pengels22/home_controller/hardware/schematics/GREM Module.pdf

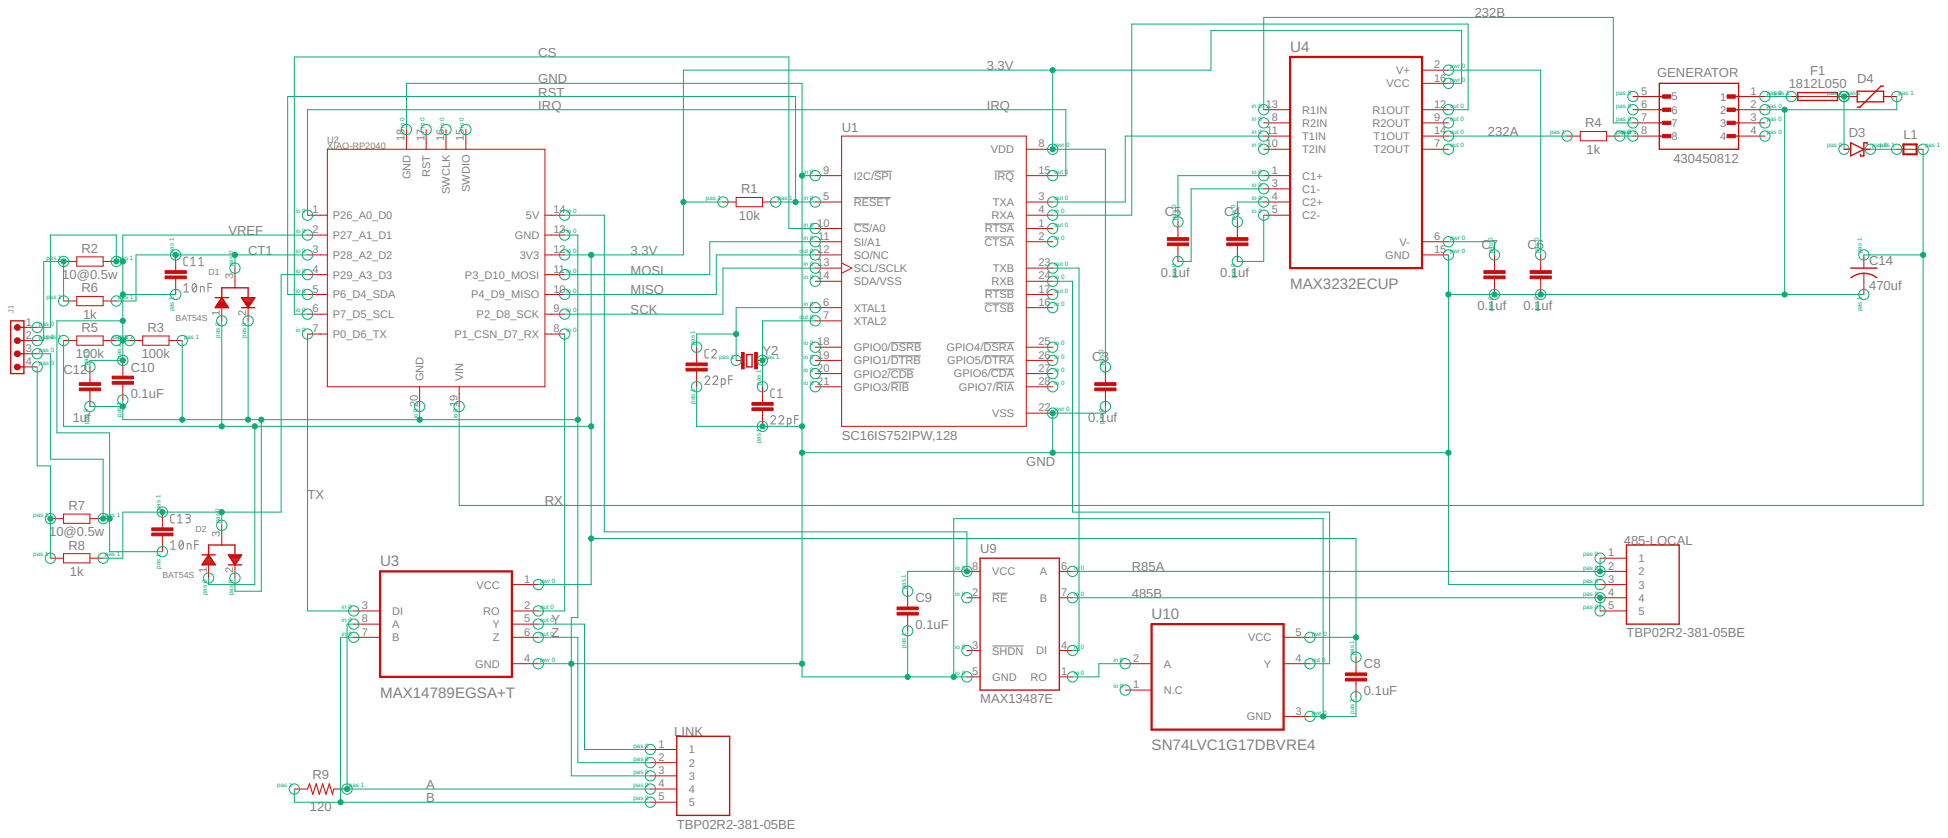
[picture p1: page 1]

U3 | RX | SC16IS752IPW,128

GND
