pengels22/home_controller/hardware/schematics/485 Module.pdf

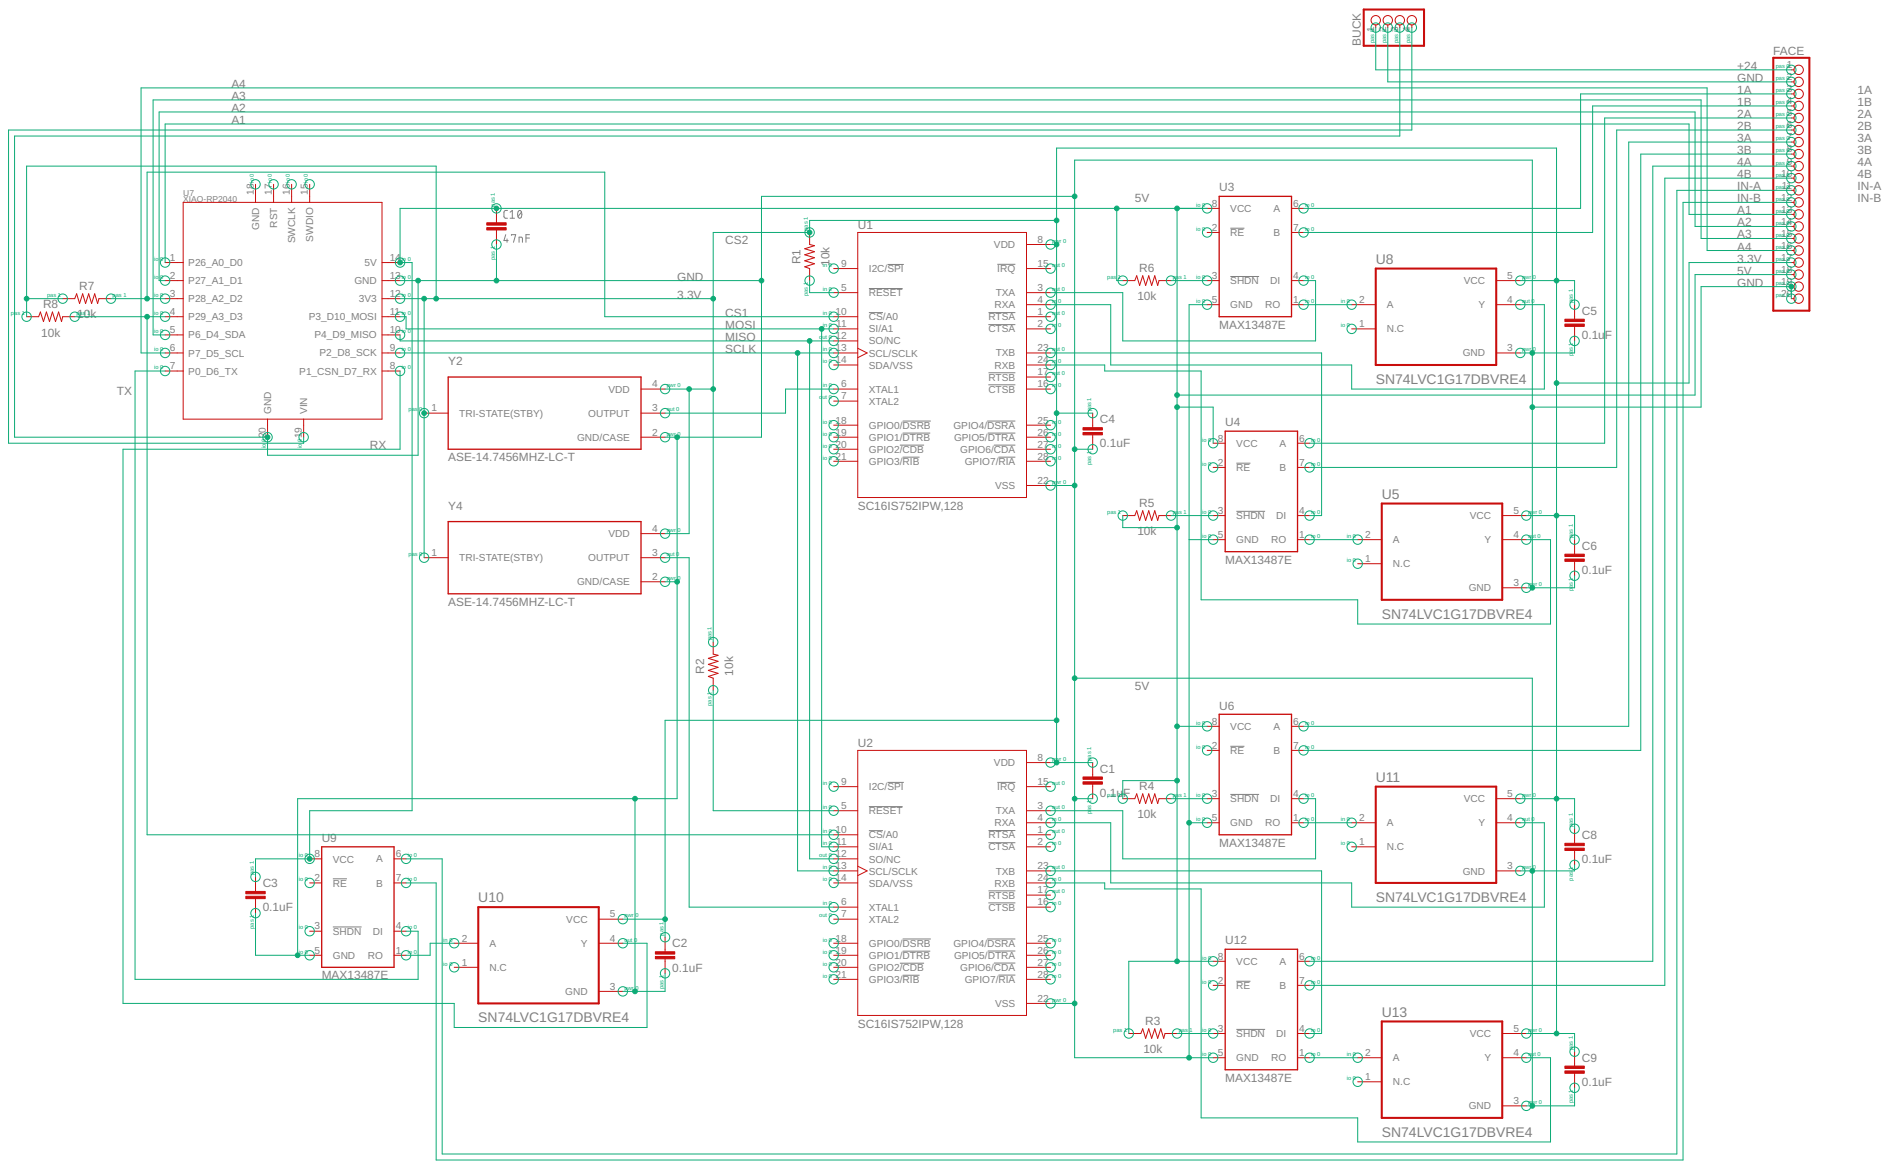
[picture p2: page 1]
