pengels22/home_controller/hardware/schematics/AIO Module.pdf

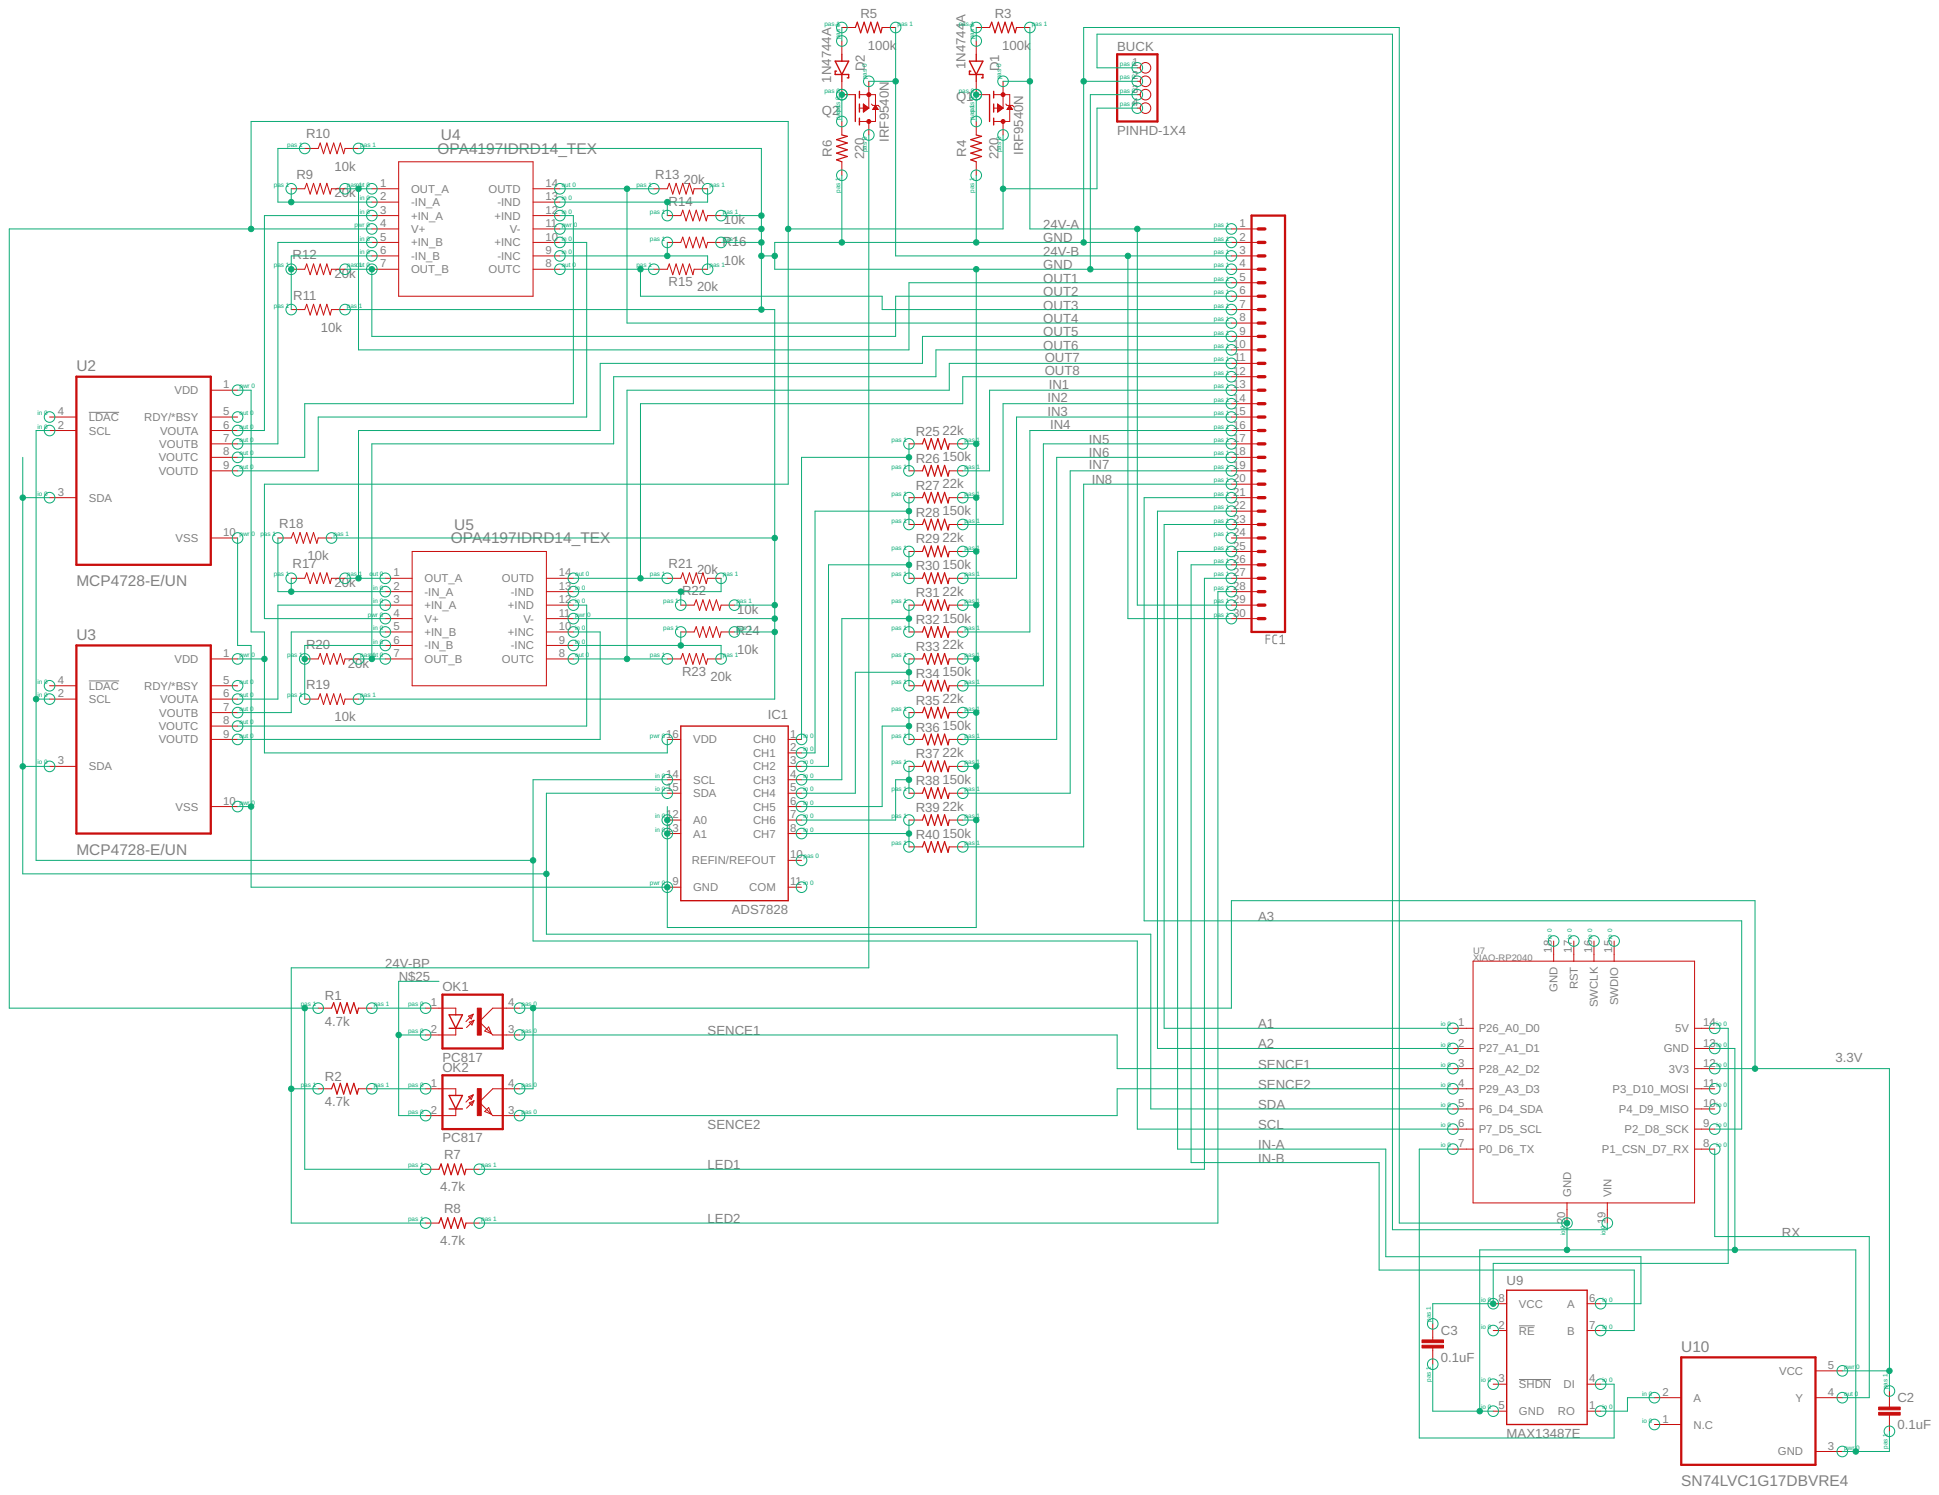
[picture p3: page 1]
