pengels22/home_controller/hardware/schematics/DI Module.pdf

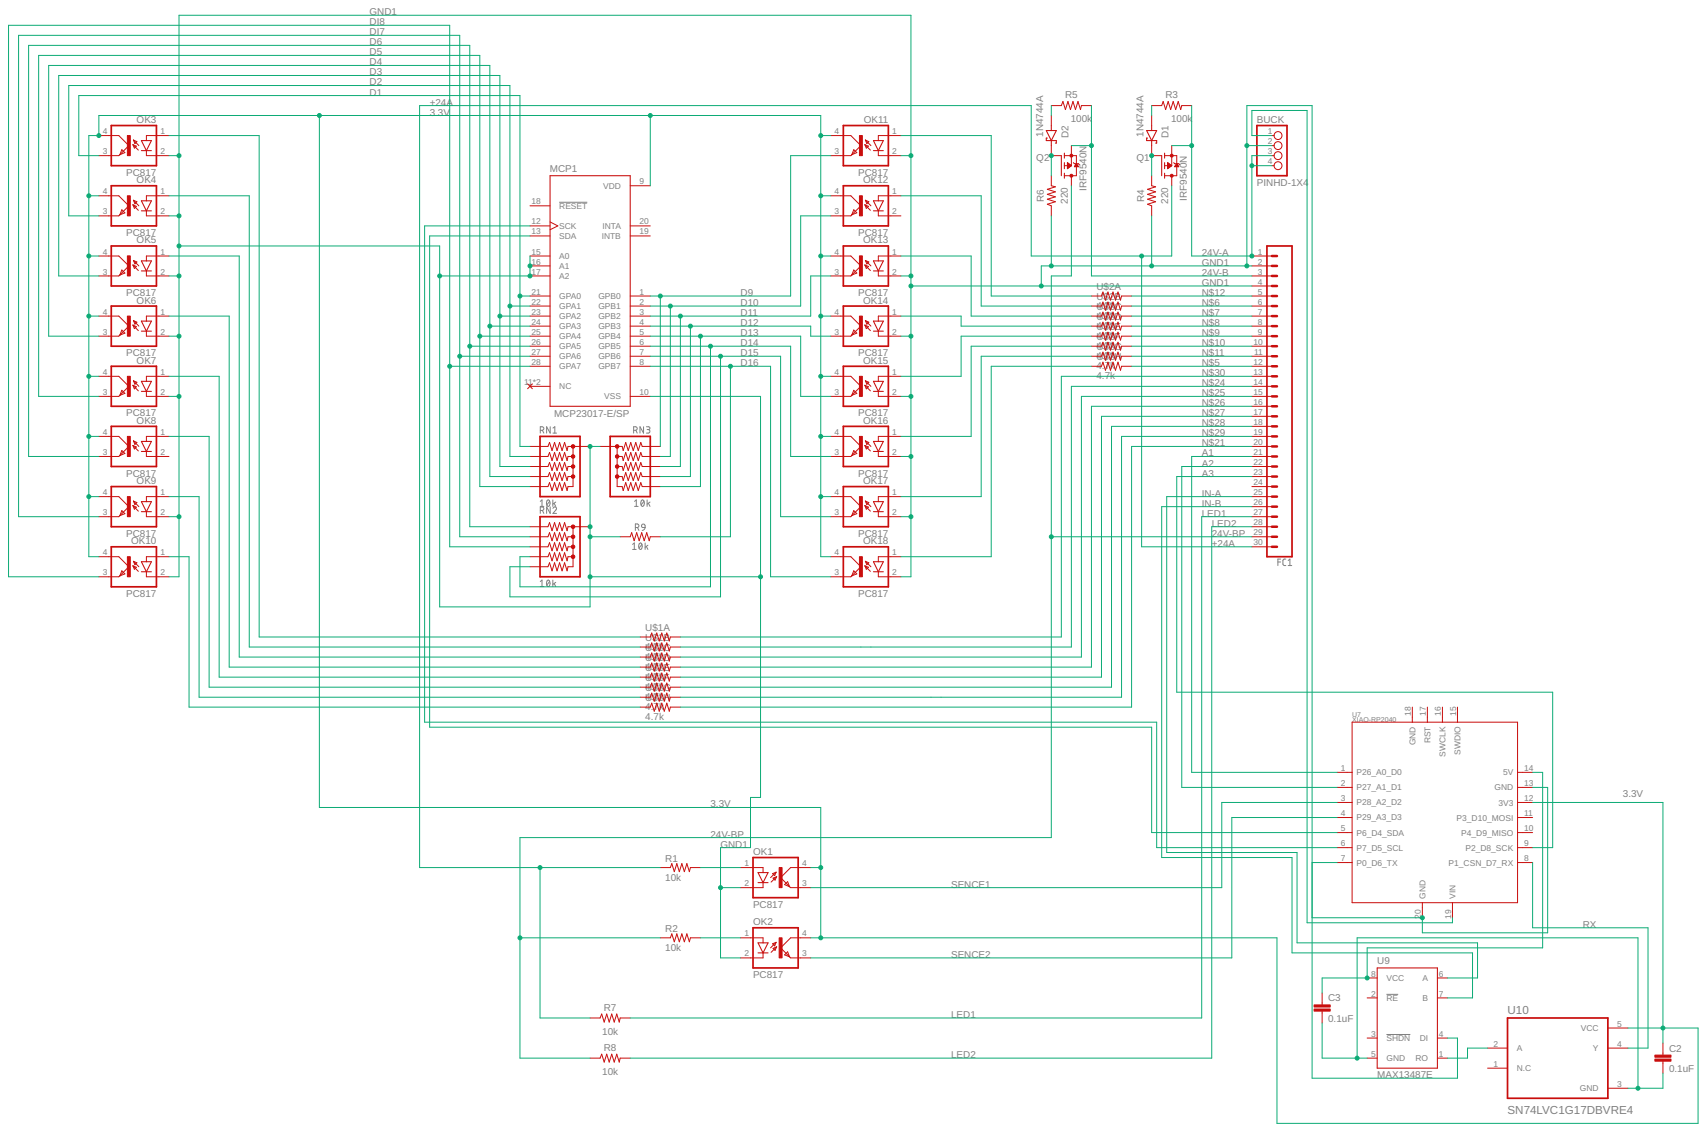
[picture p4: page 1]
