pengels22/home_controller/hardware/schematics/DO Module.pdf

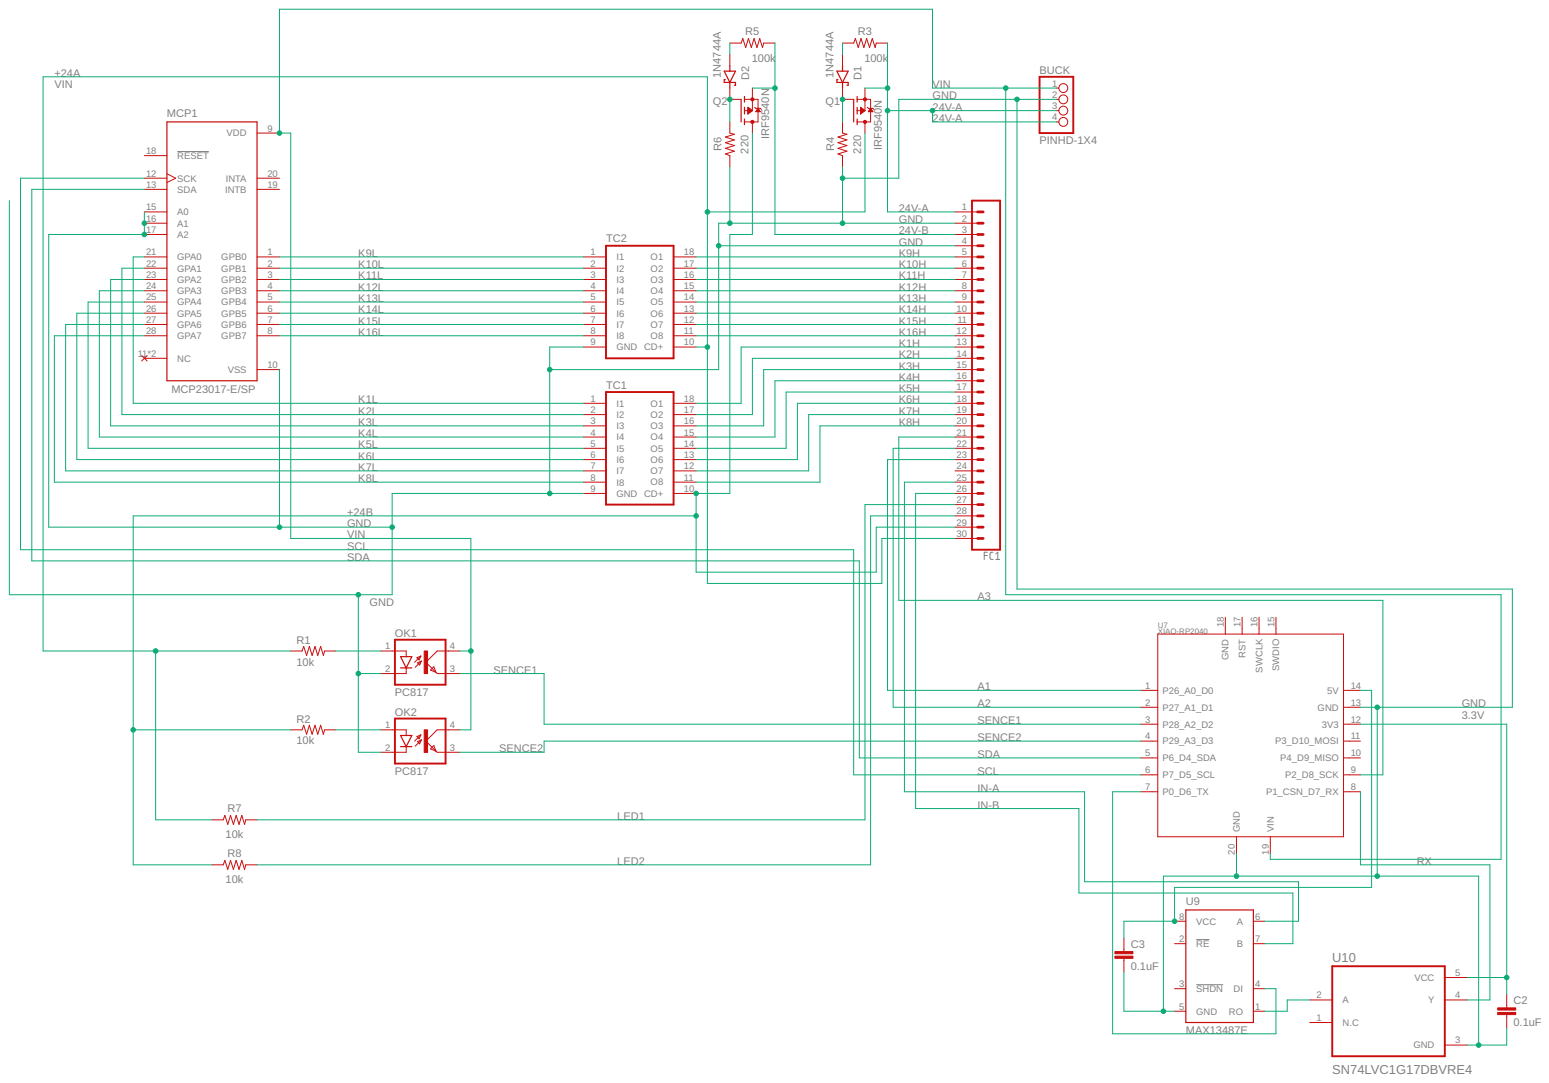
[picture p5: page 1]
