pengels22/home_controller/hardware/schematics/Generator Module.pdf

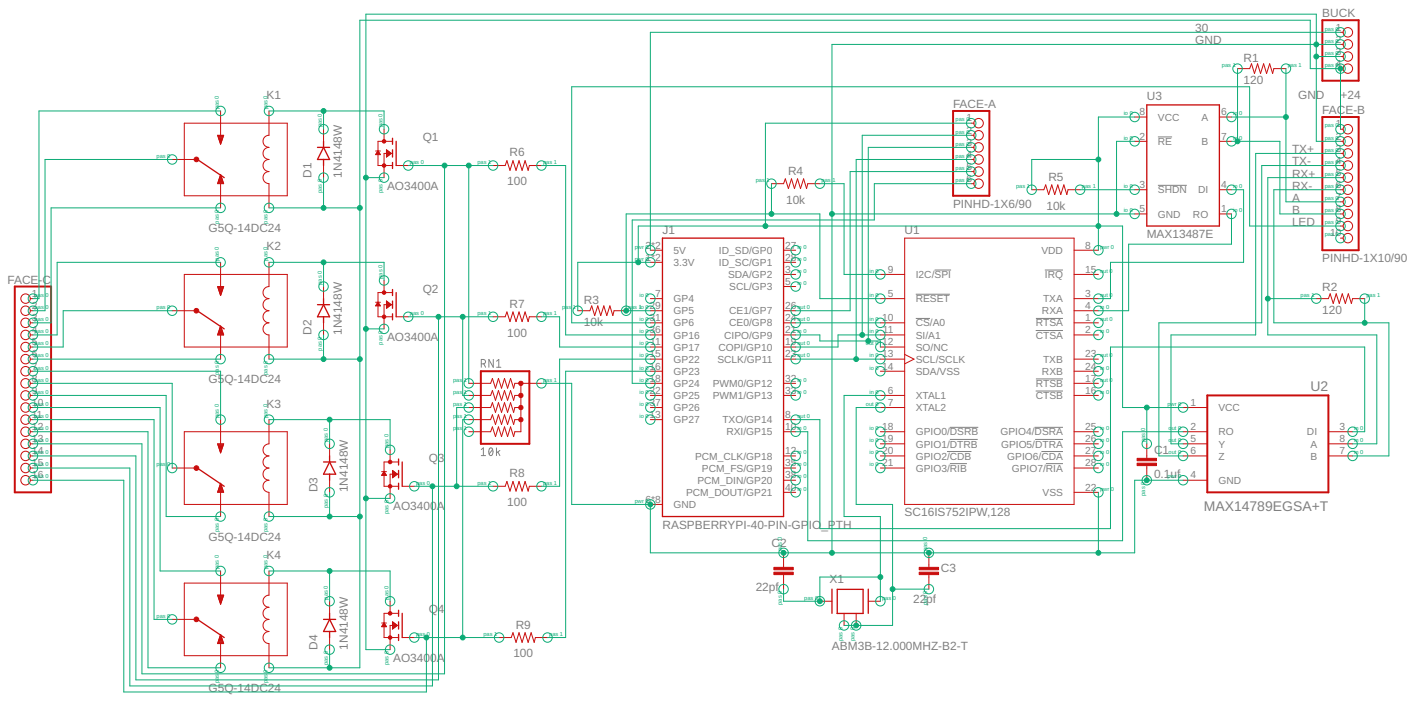
[picture p6: page 1]
