pengels22/home_controller/hardware/schematics/Head Module.pdf

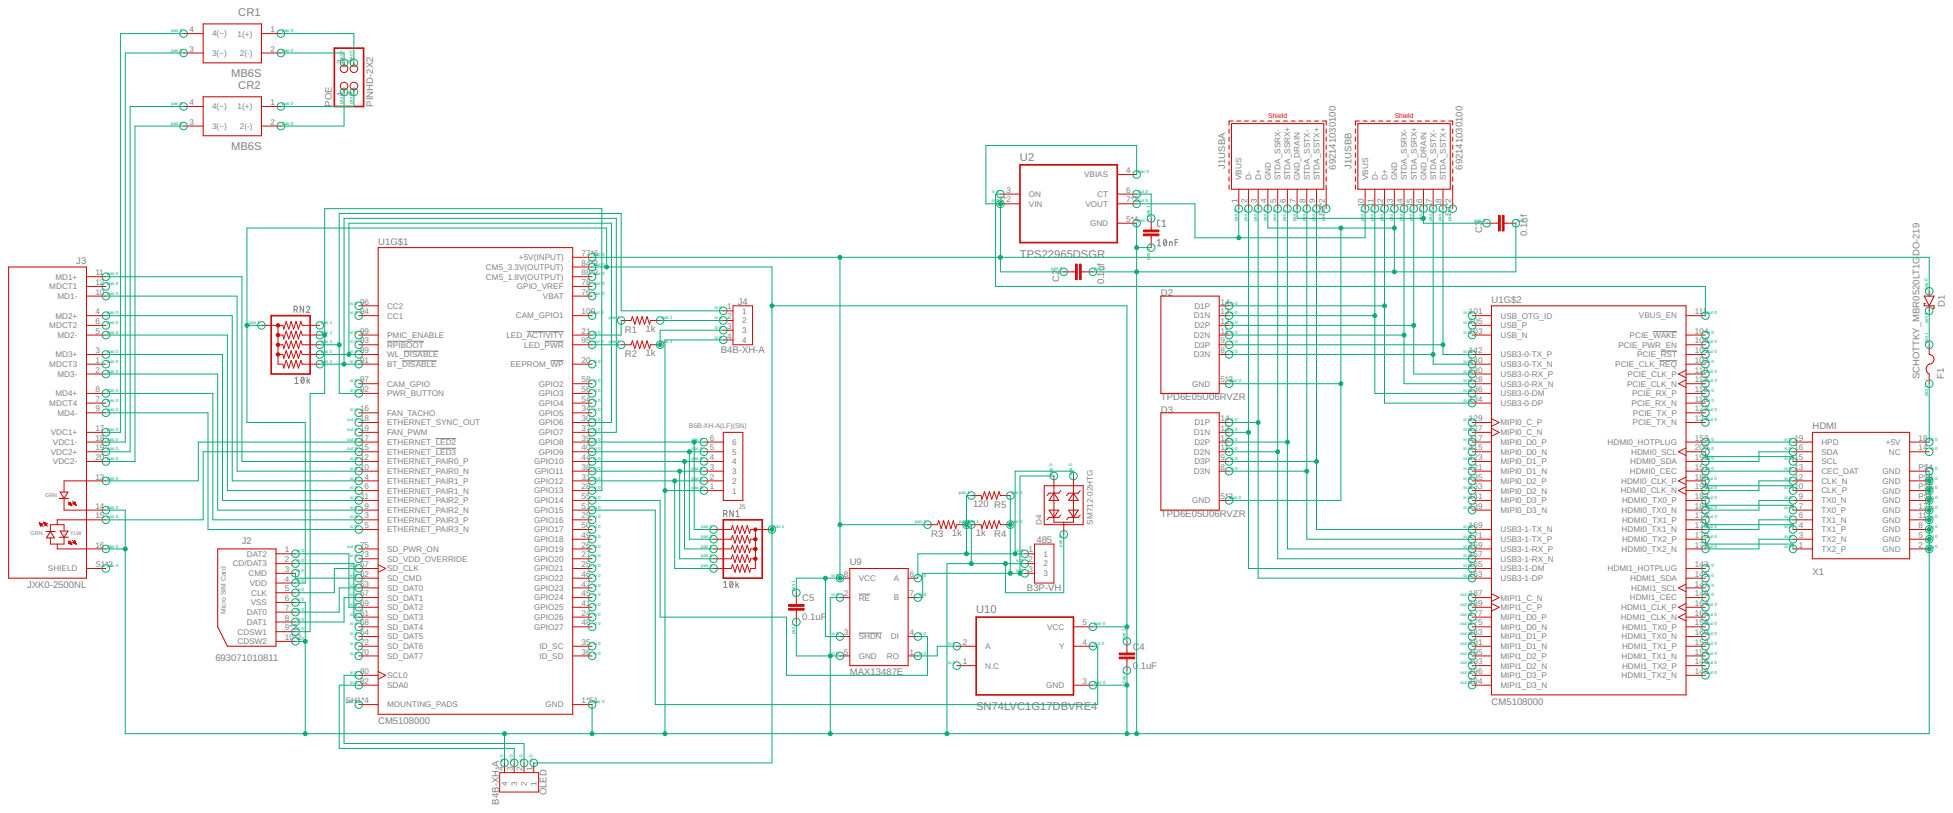
[picture p7: page 1]
