pengels22/home_controller/hardware/schematics/i2c Module.pdf

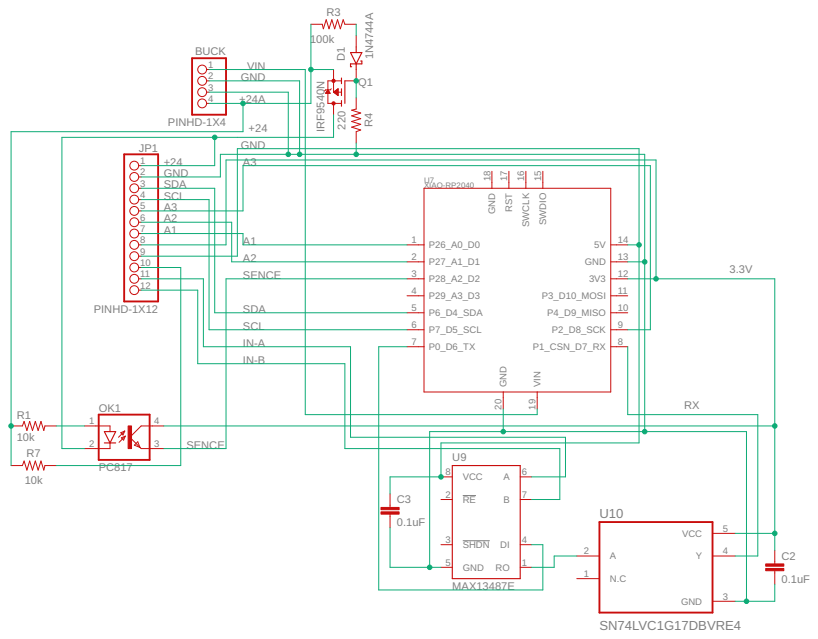
[picture p8: page 1]
