pengels22/home_controller/home_controller/server.py

import json
import os
import re
import sys
from pathlib import Path
import socket
import subprocess
import time
from typing import Any, Dict, Optional, Set, Tuple
# Expansion card settings route

from flask import (
    Flask,
    jsonify,
    request,
    render_template,
    send_from_directory,
    abort,
)
import traceback
from home_controller.core.backend import HomeControllerBackend
from home_controller.config import aio_max_voltage
from home_controller.core import i2c_catalog

# ------------------------------------------------------------
# Paths (absolute, based on this file)
# ------------------------------------------------------------
BASE_DIR = Path(__file__).resolve().parent  # .../home_controller/
TEMPLATES_DIR = BASE_DIR / "web" / "templates"
STATIC_DIR = BASE_DIR / "web" / "static"

# Generator defaults (hostname provided by user) — retained for compatibility; not used now.
Generator_HOST = os.getenv("Generator_HOST", "Generator_PI")
Generator_PORT = int(os.getenv("Generator_PORT", "9082"))
Generator_TIMEOUT = float(os.getenv("Generator_TIMEOUT", "3.0"))
Generator_CONTACTS_FILE = BASE_DIR / "config" / "Generator_contacts.json"
Generator_CONTACT_COUNT = 4
RS485_ONLY = True  # disable direct I2C bus access; only RS485 bridge I2C paths remain
# ------------------------------------------------------------
# Flask app
# ------------------------------------------------------------

app = Flask(
    __name__,
    template_folder=str(TEMPLATES_DIR),
    static_folder=str(STATIC_DIR),
)
def _parse_i2c_address(addr_str: str) -> int:
    s = (addr_str or "").strip().lower()
    if not s:
        raise ValueError("address is empty")

    if s.startswith("0x"):
        v = int(s, 16)
    elif all(c in "0123456789abcdef" for c in s) and any(c in "abcdef" for c in s):
        # has hex letters => hex
        v = int(s, 16)
    elif all(c in "0123456789abcdef" for c in s) and len(s) <= 2:
        # ambiguous "20" — in I2C land people usually mean hex
        v = int(s, 16)
    else:
        # decimal
        v = int(s, 10)

    if v < 0x03 or v > 0x77:
        raise ValueError(f"address out of 7-bit range: {hex(v)}")
    return v


def _parse_Generator_address(addr_str: str) -> int:
    """
    Parse the Generator RS485 address (allows values as low as 0x01).
    Accepts hex strings (0x01) or plain integers.
    """
    s = (addr_str or "").strip().lower()
    if not s:
        raise ValueError("address is empty")
    if s.startswith("0x"):
        v = int(s, 16)
    else:
        v = int(s, 0)
    if v < 0x01 or v > 0x7F:
        raise ValueError(f"address out of range: {hex(v)}")
    return v


def _scan_i2c_addresses(bus: int, cache_seconds: float = 1.5) -> Tuple[Set[int], Optional[str]]:
    """
    Returns (set_of_detected_addresses, error_string_or_None)

    Uses `i2cdetect -y <bus>` if available.
    Caches results briefly to avoid hammering the bus.
    """
    global _I2C_CACHE

    if RS485_ONLY:
        return set(), "I2C disabled (RS485-only mode)"

    now = time.time()
    last_ts, last_addrs, last_err = _I2C_CACHE
    if (now - last_ts) < cache_seconds:
        return set(last_addrs), last_err

    # Ensure device exists (Linux i2c-dev)
    devnode = f"/dev/i2c-{bus}"
    if not Path(devnode).exists():
        err = f"{devnode} not found (enable I2C + i2c-dev on this system)"
        _I2C_CACHE = (now, set(), err)
        return set(), err

    try:
        # i2cdetect output is the most compatible / least dependency approach
        r = subprocess.run(
            ["i2cdetect", "-y", str(bus)],
            stdout=subprocess.PIPE,
            stderr=subprocess.PIPE,
            text=True,
            timeout=2.5,
        )
        if r.returncode != 0:
            err = (r.stderr or r.stdout or "").strip() or "i2cdetect failed"
            _I2C_CACHE = (now, set(), err)
            return set(), err

        addrs: Set[int] = set()
        for line in (r.stdout or "").splitlines():
            line = line.strip()
            # rows look like: "20: -- -- 22 -- -- -- -- --"
            if len(line) < 3 or ":" not in line:
                continue
            prefix, rest = line.split(":", 1)
            prefix = prefix.strip()
            if len(prefix) != 2:
                continue

            tokens = rest.strip().split()
            for t in tokens:
                tt = t.strip().lower()
                if tt in ("--", "uu"):
                    continue
                # actual addresses appear as two hex digits (e.g. '20', '3c')
                if len(tt) == 2 and all(c in "0123456789abcdef" for c in tt):
                    addrs.add(int(tt, 16))

        _I2C_CACHE = (now, set(addrs), None)
        return addrs, None

    except FileNotFoundError:
        err = "i2cdetect not installed (install `i2c-tools`)"
        _I2C_CACHE = (now, set(), err)
        return set(), err
    except Exception as e:
        err = f"i2c scan error: {e}"
        _I2C_CACHE = (now, set(), err)
        return set(), err


def get_lan_ip() -> str:
    """
    Best-effort LAN IP detection.
    This uses a UDP "connect" trick (no packets required) to learn the outbound interface IP.
    Falls back to hostname lookup.
    """
    # Primary: UDP connect trick (no packets sent)
    try:
        s = socket.socket(socket.AF_INET, socket.SOCK_DGRAM)
        s.connect(("8.8.8.8", 80))
        ip = s.getsockname()[0]
        s.close()
        return ip
    except Exception:
        pass

    # Secondary: non-loopback addresses from hostname resolution
    try:
        host, aliases, addrs = socket.gethostbyname_ex(socket.gethostname())
        for cand in addrs:
            if cand and not cand.startswith("127."):
                return cand
    except Exception:
        pass

    # Tertiary: parse `hostname -I` if available (no internet needed)
    try:
        out = subprocess.check_output(["hostname", "-I"], text=True, timeout=1.0)
        tokens = [t for t in out.strip().split() if t and not t.startswith("127.")]
        if tokens:
            return tokens[0]
    except Exception:
        pass

    # Quaternary: parse `ip -4 route get` (works even without internet by using default route)
    try:
        out = subprocess.check_output(["ip", "-4", "route", "get", "1.1.1.1"], text=True, timeout=1.0)
        parts = out.split()
        if "src" in parts:
            idx = parts.index("src")
            if idx + 1 < len(parts):
                cand = parts[idx + 1]
                if cand and not cand.startswith("127."):
                    return cand
    except Exception:
        pass

    # Final fallback: first non-loopback IPv4 from `ip -4 addr show`
    try:
        out = subprocess.check_output(["ip", "-4", "addr", "show"], text=True, timeout=1.0)
        for line in out.splitlines():
            line = line.strip()
            if line.startswith("inet "):
                cand = line.split()[1].split("/")[0]
                if cand and not cand.startswith("127."):
                    return cand
    except Exception:
        pass

    return "0.0.0.0"


def internet_ok_tcp() -> bool:
    """
    More reliable than ping permissions:
    try a TCP connect to 8.8.8.8:53 (DNS).
    """
    try:
        with socket.create_connection(("8.8.8.8", 53), timeout=1.5):
            return True
    except Exception:
        return False

# ------------------------------------------------------------
# Per-module config API (invert/override for DI/DO)
# ------------------------------------------------------------
@app.get("/api/module_config_get")
def api_module_config_get():
    """Get per-channel config (invert/override) for a module."""
    module_id = request.args.get("module_id", "").strip()
    if not module_id:
        return jsonify({"ok": False, "error": "module_id required"}), 400
    idx = backend._find_module_index(module_id)
    if idx < 0:
        return jsonify({"ok": False, "error": "module not found"}), 404
    m = backend.cfg.modules[idx]
    # DI/DO (invert/override) and RS485 (bus_enable)
    if m.type not in ("di", "do", "rs485"):
        return jsonify({"ok": False, "error": "not a DI/DO/RS485 module"}), 400
    cfg = backend.load_module_config(m.type, m.address_hex)
    if m.type in ("di", "do"):
        invert = cfg.get("invert", {})
        override = cfg.get("override", {})
        return jsonify({"ok": True, "invert": invert, "override": override})
    else:
        bus_enable = cfg.get("bus_enable", {})
        return jsonify({"ok": True, "bus_enable": bus_enable})

@app.post("/api/module_config_set")
def api_module_config_set():
    """Set per-channel config (invert/override) for a module."""
    data = request.get_json(force=True, silent=True) or {}
    module_id = str(data.get("module_id", "")).strip()
    if not module_id:
        return jsonify({"ok": False, "error": "module_id required"}), 400
    idx = backend._find_module_index(module_id)
    if idx < 0:
        return jsonify({"ok": False, "error": "module not found"}), 404
    m = backend.cfg.modules[idx]
    if m.type in ("di", "do"):
        cfg = backend.load_module_config(m.type, m.address_hex)
        # Update invert/override dicts
        invert = cfg.get("invert", {})
        override = cfg.get("override", {})
        # Accept full dicts or single channel update
        if "invert" in data:
            if isinstance(data["invert"], dict):
                invert.update({str(k): bool(v) for k, v in data["invert"].items()})
            elif "channel" in data and isinstance(data["invert"], bool):
                invert[str(data["channel"])] = data["invert"]
        if "override" in data:
            if isinstance(data["override"], dict):
                override.update({str(k): str(v) for k, v in data["override"].items()})
            elif "channel" in data and data["override"] in ("on", "off", "none"):
                override[str(data["channel"])] = str(data["override"])
        cfg["invert"] = invert
        cfg["override"] = override
        backend.save_module_config(m.type, m.address_hex, cfg)
        return jsonify({"ok": True, "invert": invert, "override": override})
    else:
        cfg = backend.load_module_config(m.type, m.address_hex)
        bus_enable = cfg.get("bus_enable", {})
        if "bus_enable" in data and isinstance(data["bus_enable"], dict):
            for k, v in data["bus_enable"].items():
                bus_enable[str(k)] = bool(v)
        elif "bus" in data and "enabled" in data:
            bus_enable[str(data["bus"])] = bool(data["enabled"])
        cfg["bus_enable"] = bus_enable
        backend.save_module_config(m.type, m.address_hex, cfg)
        return jsonify({"ok": True, "bus_enable": bus_enable})

# ------------------------------------------------------------
# all apis below
## Health check (API)
## ------------------------------------------------------------

# ------------------------------------------------------------
# Module config popup routes (DI, DO, AIO, RS485-to-I2C)
# ------------------------------------------------------------
@app.route("/di_config_popup")
def di_config_popup():
    return render_template("di_config.html")

@app.route("/do_config_popup")
def do_config_popup():
    return render_template("do_config.html")

@app.route("/aio_config_popup")
def aio_config_popup():
    return render_template("aio_config.html")

# RS485 config popup (uses same sensor list, 40 channels)
@app.route("/rs485_config_popup")
def rs485_config_popup():
    i2c_sensors = i2c_catalog.load_catalog()
    return render_template("rs485_to_i2c_config.html", i2c_sensors=i2c_sensors)

# Generator config popup (simple name/address)
@app.route("/generator_config_popup")
@app.route("/Generator_config_popup")  # backward compatibility
def generator_config_popup():
    return render_template("generator_config.html")


@app.get("/api/i2c/supported")
def api_i2c_supported():
    return jsonify({"ok": True, "sensors": i2c_catalog.load_catalog()})

@app.route("/i2c_module_ch_config", methods=["GET", "POST"])
@app.route("/expansion_config", methods=["GET", "POST"])  # backward-compat alias
def i2c_module_ch_config():
    # Expansion module replaced by RS485-to-I2C bridge; keep page as a notice.
    return render_template(
        "i2c_module_ch_config.html",
        exp=None,
        exp_cfg_path=None,
        error="Expansion module deprecated; use the RS485 I2C Bridge configuration instead.",
    )

@app.get("/api/aio_max_voltage/<module_id>")
def api_get_aio_max_voltage(module_id: str):
    # Find module by id and get its I2C address
    idx = backend._find_module_index(module_id)
    if idx < 0:
        return jsonify({"ok": False, "error": "module not found"}), 404
    m = backend.cfg.modules[idx]
    if m.type != "aio":
        return jsonify({"ok": False, "error": "not an AIO module"}), 400
    data = aio_max_voltage.load_aio_max_voltage(m.id)
    return jsonify({"ok": True, "data": data})

@app.post("/api/aio_max_voltage/<module_id>")
def api_set_aio_max_voltage(module_id: str):
    idx = backend._find_module_index(module_id)
    if idx < 0:
        return jsonify({"ok": False, "error": "module not found"}), 404
    m = backend.cfg.modules[idx]
    if m.type != "aio":
        return jsonify({"ok": False, "error": "not an AIO module"}), 400
    data = request.get_json(force=True, silent=True) or {}
    # Expect {"in": {...}, "out": {...}}
    if not ("in" in data and "out" in data):
        return jsonify({"ok": False, "error": "missing in/out blocks"}), 400
    aio_max_voltage.save_aio_max_voltage(m.id, data)
    return jsonify({"ok": True})

# ------------------------------------------------------------
# Paths (absolute, based on this file)
# ------------------------------------------------------------
BASE_DIR = Path(__file__).resolve().parent  # .../home_controller/
TEMPLATES_DIR = BASE_DIR / "web" / "templates"
STATIC_DIR = BASE_DIR / "web" / "static"

# UI labels storage (module + channel naming)
LABELS_DIR = BASE_DIR / "config"
LABELS_FILE = LABELS_DIR / "ui_labels.json"

# I2C bus to scan (Pi default is usually 1)
I2C_BUS = int(os.getenv("HC_I2C_BUS", "1"))

# Small cache so we don't run i2cdetect constantly
_I2C_CACHE: Tuple[float, Set[int], Optional[str]] = (0.0, set(), None)  # (ts, addrs, err)


def _load_labels() -> dict:
    try:
        if not LABELS_FILE.exists():
            return {}
        with open(LABELS_FILE, "r", encoding="utf-8") as f:
            data = json.load(f)
        return data if isinstance(data, dict) else {}
    except Exception:
        return {}


def _save_labels(data: dict) -> None:
    LABELS_DIR.mkdir(parents=True, exist_ok=True)
    tmp = LABELS_FILE.with_suffix(".tmp")
    with open(tmp, "w", encoding="utf-8") as f:
        json.dump(data, f, indent=2, sort_keys=True)
    tmp.replace(LABELS_FILE)


# ------------------------------------------------------------
# Generator helpers
# ------------------------------------------------------------

def _default_Generator_contacts() -> Dict[str, Any]:
    return {
        "contacts": [
            {
                "id": i,
                "name": f"Dry Contact {i}",
                "cmd_on": f"set_button_command=contact{i}:on",
                "cmd_off": f"set_button_command=contact{i}:off",
                "state": "unknown",
            }
            for i in range(1, Generator_CONTACT_COUNT + 1)
        ]
    }


def _load_Generator_contacts() -> Dict[str, Any]:
    try:
        if not Generator_CONTACTS_FILE.exists():
            return _default_Generator_contacts()
        with open(Generator_CONTACTS_FILE, "r", encoding="utf-8") as f:
            data = json.load(f)
        if not isinstance(data, dict):
            return _default_Generator_contacts()
        if "contacts" not in data or not isinstance(data["contacts"], list):
            data["contacts"] = _default_Generator_contacts()["contacts"]
        return data
    except Exception:
        return _default_Generator_contacts()


def _save_Generator_contacts(data: Dict[str, Any]) -> None:
    try:
        Generator_CONTACTS_FILE.parent.mkdir(parents=True, exist_ok=True)
        tmp = Generator_CONTACTS_FILE.with_suffix(".tmp")
        with open(tmp, "w", encoding="utf-8") as f:
            json.dump(data, f, indent=2, sort_keys=True)
        tmp.replace(Generator_CONTACTS_FILE)
    except Exception:
        pass


def _build_contact_command(entry: Dict[str, Any], state: str) -> str:
    template = ""
    if "cmd_template" in entry and entry["cmd_template"]:
        template = str(entry["cmd_template"])
    elif state == "on" and entry.get("cmd_on"):
        template = str(entry["cmd_on"])
    elif state == "off" and entry.get("cmd_off"):
        template = str(entry["cmd_off"])

    if template:
        try:
            return template.format(contact=entry.get("id"), state=state)
        except Exception:
            return template

    # Fallback to simple set_button_command pattern
    return f"set_button_command=contact{entry.get('id', '')}:{state}"


def _update_contact_state(contacts_cfg: Dict[str, Any], contact_id: int, state: str) -> None:
    for c in contacts_cfg.get("contacts", []):
        try:
            if int(c.get("id", -1)) == int(contact_id):
                c["state"] = state
                c["updated"] = int(time.time())
                break
        except Exception:
            continue


def _walk_items(obj):
    if isinstance(obj, dict):
        for k, v in obj.items():
            yield k, v
            for nested in _walk_items(v):
                yield nested
    elif isinstance(obj, list):
        for item in obj:
            for nested in _walk_items(item):
                yield nested


def _extract_number(val):
    if isinstance(val, (int, float)):
        return float(val)
    if isinstance(val, str):
        m = re.search(r"-?\d+(?:\.\d+)?", val)
        if m:
            try:
                return float(m.group())
            except Exception:
                return None
    return None


def _find_first(obj, key_predicate):
    for k, v in _walk_items(obj):
        try:
            if key_predicate(k, v):
                return v
        except Exception:
            continue
    return None


def _find_numeric(obj, key_predicate):
    for k, v in _walk_items(obj):
        try:
            if key_predicate(k, v):
                num = _extract_number(v)
                if num is not None:
                    return num
        except Exception:
            continue
    return None


def _parse_Generator_status(raw: Dict[str, Any]) -> Dict[str, Any]:
    out: Dict[str, Any] = {}

    rpm = _find_numeric(raw, lambda k, _v: isinstance(k, str) and "rpm" in k.lower())
    if rpm is not None:
        out["rpm"] = int(rpm) if rpm.is_integer() else rpm

    hz = _find_numeric(raw, lambda k, _v: isinstance(k, str) and ("hz" in k.lower() or "freq" in k.lower()))
    if hz is not None:
        out["hz"] = hz

    temp = _find_numeric(raw, lambda k, _v: isinstance(k, str) and "temp" in k.lower())
    if temp is not None:
        out["temp_c"] = temp

    batt_v = _find_numeric(raw, lambda k, _v: isinstance(k, str) and "battery" in k.lower() and "volt" in k.lower())
    if batt_v is not None:
        out["battery_v"] = batt_v

    batt_pct = _find_numeric(raw, lambda k, _v: isinstance(k, str) and "battery" in k.lower() and "%" in k.lower())
    if batt_pct is not None:
        out["battery_pct"] = batt_pct

    health = _find_first(raw, lambda k, v: isinstance(k, str) and "health" in k.lower() and isinstance(v, (str, int, float)))
    if health is not None:
        out["system_health"] = str(health)

    run_state = _find_first(raw, lambda k, v: isinstance(k, str) and "engine" in k.lower() and "state" in k.lower())
    if run_state is None:
        run_state = _find_first(raw, lambda k, v: isinstance(k, str) and k.lower() in ("state", "status") and isinstance(v, str))
    if run_state is not None:
        out["run_state"] = str(run_state)
        out["running"] = str(run_state).lower() in ("run", "running", "on", "active")
    elif rpm is not None:
        out["running"] = rpm > 0

    out["ts"] = int(time.time())
    out["raw"] = raw
    return out




# Backend instance. Support developer simulation mode via `-dev` flag or env var.
args = [a.lower() for a in sys.argv[1:]]
DEV_MODE = any(a in ("-dev", "--dev", "dev") for a in args) or os.getenv("HC_DEV", "0").lower() in ("1", "true", "yes")
backend = HomeControllerBackend()
if DEV_MODE:
    dev_file = os.getenv("HC_DEV_FILE", None)
    backend.enable_dev_mode(dev_file)
    print(f"DEV MODE enabled; dev file={backend._dev_file}")

# On startup, scan I2C and warn if any configured module is missing
def _startup_module_check():
    if RS485_ONLY or getattr(backend, "_force_rs485", False):
        print("[INFO] RS485-only mode; skipping I2C presence scan.")
        return
    addrs, _err = _scan_i2c_addresses(I2C_BUS)
    present_hex = {f"0x{a:02x}" for a in addrs}
    missing = []
    for m in backend.list_modules():
        # Generator is not on the I2C bus; skip presence check
        if m.type == "Generator":
            continue
        if m.address_hex.lower() not in present_hex:
            missing.append(m)
    if missing:
        print("[WARNING] The following modules are configured but not detected on the I2C bus:")
        for m in missing:
            print(f"  - id={m.id} type={m.type} address={m.address_hex}")
        print("They will NOT be deleted from config. Please check wiring and power.")
    else:
        print("All configured modules detected on I2C bus.")

_startup_module_check()


# ------------------------------------------------------------
# Helpers
# ------------------------------------------------------------
@app.after_request
def _no_cache_for_api(resp):
    # Prevent stale head/IP/network/I2C status in the browser
    if request.path.startswith("/api/") or request.path == "/":
        resp.headers["Cache-Control"] = "no-store, no-cache, must-revalidate, max-age=0"
        resp.headers["Pragma"] = "no-cache"
        resp.headers["Expires"] = "0"
    return resp

@app.get("/")
def root():
    # Serve the main UI by default
    try:
        return render_template("index.html")
    except Exception as e:
        import traceback
        print("[UI ERROR] Could not render index.html:", e)
        traceback.print_exc()
        # fallback to JSON health if template rendering fails
        return jsonify(
            {
                "service": "home_controller",
                "status": "running",
                "controller_name": backend.cfg.controller_name,
                "modules": len(backend.list_modules()),
                "ui_error": str(e),
            }
        )


# ------------------------------------------------------------
# UI pages
# ------------------------------------------------------------
@app.get("/ui")
def ui_index():
    return render_template("index.html")


@app.get("/ui/add")
def ui_add():
    return render_template("add_module.html")


# ------------------------------------------------------------
# I2C scan API
# ------------------------------------------------------------
@app.get("/api/i2c_scan")
def api_i2c_scan():
    return jsonify({
        "addresses": [],
        "error": None,
        "ts": int(time.time()),
    })


# ------------------------------------------------------------
# Modules API
# ------------------------------------------------------------
@app.get("/modules")
def modules_list():
    out = []
    for m in backend.list_modules():
        addr_hex = str(m.address_hex).lower().strip()
        out.append(
            {
                "id": m.id,
                "type": m.type,
                "address": addr_hex,
                "name": m.name,
                "present": True,
                "module_num": m.module_num,
                "last_error": backend.get_last_error(m.id),
            }
        )
    return jsonify(out)


@app.get("/modules/Generator/<module_id>/detail")
@app.get("/modules/generator/<module_id>/detail")
def generator_detail(module_id: str):
    # Find module by id
    mod = next((m for m in backend.list_modules() if m.id == module_id), None)
    if not mod:
        abort(404)
    return render_template("generator_detail.html", module=mod, hide_nav=True)


# ------------------------------------------------------------
# Generator API
# ------------------------------------------------------------
@app.get("/api/Generator/<module_id>/status")
@app.get("/api/generator/<module_id>/status")
def api_generator_status(module_id: str):
    mod = next((m for m in backend.list_modules() if m.id == module_id), None)
    if not mod or mod.type != "Generator":
        return jsonify({"ok": False, "error": "module not found"}), 404

    try:
        res = backend.read_module(module_id)
        if not res.get("ok"):
            return jsonify({"ok": False, "error": res.get("error")}), 502
        out = dict(res)
        out["module_id"] = module_id
        out["host"] = "RS485"
        out["port"] = backend._rs485_port  # type: ignore
        return jsonify(out)
    except Exception as e:
        tb = traceback.format_exc()
        return jsonify({"ok": False, "error": str(e), "trace": tb}), 502


@app.get("/api/Generator/<module_id>/contacts")
@app.get("/api/generator/<module_id>/contacts")
def api_generator_contacts(module_id: str):
    mod = next((m for m in backend.list_modules() if m.id == module_id), None)
    if not mod or mod.type != "Generator":
        return jsonify({"ok": False, "error": "module not found"}), 404
    cfg = _load_Generator_contacts()
    return jsonify({"ok": True, "module_id": module_id, "contacts": cfg.get("contacts", [])})


@app.post("/api/Generator/<module_id>/contacts/<int:contact_id>")
@app.post("/api/generator/<module_id>/contacts/<int:contact_id>")
def api_generator_set_contact(module_id: str, contact_id: int):
    mod = next((m for m in backend.list_modules() if m.id == module_id), None)
    if not mod or mod.type != "Generator":
        return jsonify({"ok": False, "error": "module not found"}), 404

    if contact_id < 1 or contact_id > Generator_CONTACT_COUNT:
        return jsonify({"ok": False, "error": f"contact must be 1-{Generator_CONTACT_COUNT}"}), 400

    data = request.get_json(force=True, silent=True) or {}
    raw_state = data.get("state")
    state = ""
    if isinstance(raw_state, bool):
        state = "on" if raw_state else "off"
    elif isinstance(raw_state, (int, float)):
        state = "on" if raw_state else "off"
    elif isinstance(raw_state, str):
        rs = raw_state.strip().lower()
        if rs in ("on", "1", "true", "yes"):
            state = "on"
        elif rs in ("off", "0", "false", "no"):
            state = "off"
    if state not in ("on", "off"):
        return jsonify({"ok": False, "error": "state must be on/off"}), 400

    cfg = _load_Generator_contacts()
    entry = None
    for c in cfg.get("contacts", []):
        try:
            if int(c.get("id", -1)) == int(contact_id):
                entry = c
                break
        except Exception:
            continue
    if entry is None:
        return jsonify({"ok": False, "error": "contact not defined"}), 404

    cmd = _build_contact_command(entry, state)

    # RS485 generator modules do not expose dry-contact writes yet; just persist desired state.
    _update_contact_state(cfg, contact_id, state)
    _save_Generator_contacts(cfg)

    return jsonify(
        {
            "ok": True,
            "module_id": module_id,
            "contact": contact_id,
            "state": state,
            "command": cmd,
            "resp": "stored (no-op for RS485 generator)",
        }
    )


@app.post("/modules/add")
def modules_add():
    data = request.get_json(force=True, silent=True) or {}
    try:
        mtype = str(data.get("type", "")).strip().lower()
        addr_str = str(data.get("address", "")).strip()
        if mtype == "Generator":
            addr_val = _parse_Generator_address(addr_str)
        else:
            addr_val = _parse_i2c_address(addr_str)
        addr_hex = f"0x{addr_val:02x}"
        # Disable I2C address validation for all modules
        m = backend.add_module(
            mtype=mtype,
            address=addr_hex,
            name=str(data.get("name", "")),
        )
        return jsonify(
            {
                "ok": True,
                "module": {
                    "id": m.id,
                    "type": m.type,
                    "address": m.address_hex,
                    "name": m.name,
                    "module_num": m.module_num,
                },
            }
        )
    except Exception as e:
        return jsonify({"ok": False, "error": str(e)}), 400


@app.post("/modules/remove")
def modules_remove():
    data = request.get_json(force=True, silent=True) or {}
    try:
        mid = str(data.get("id", ""))
        backend.remove_module(mid)

        labels = _load_labels()
        if mid in labels:
            labels.pop(mid, None)
            _save_labels(labels)

        return jsonify({"ok": True})
    except Exception as e:
        return jsonify({"ok": False, "error": str(e)}), 400


@app.post("/modules/change_address")
def modules_change_address():
    data = request.get_json(force=True, silent=True) or {}
    try:
        mid = str(data.get("id", "")).strip()
        new_addr = str(data.get("address", "")).strip()
        if not mid:
            return jsonify({"ok": False, "error": "module id required"}), 400
        if not new_addr:
            return jsonify({"ok": False, "error": "address required"}), 400

        # perform the address change in backend
        try:
            updated = backend.change_module_address(mid, new_addr)
        except Exception as e:
            return jsonify({"ok": False, "error": str(e)}), 400

        # move any saved labels for the module to the new id
        try:
            labels = _load_labels()
            if mid in labels:
                labels[updated.id] = labels.pop(mid)
                _save_labels(labels)
        except Exception:
            pass

        return jsonify({"ok": True, "module": {"id": updated.id, "address": updated.address_hex, "type": updated.type}})
    except Exception as e:
        return jsonify({"ok": False, "error": str(e)}), 400


@app.post("/modules/rename")
def modules_rename():
    data = request.get_json(force=True, silent=True) or {}
    try:
        backend.rename_module(
            module_id=str(data.get("id", "")),
            new_name=str(data.get("name", "")),
        )
        return jsonify({"ok": True})
    except Exception as e:
        return jsonify({"ok": False, "error": str(e)}), 400


@app.post("/modules/set_number")
def modules_set_number():
    data = request.get_json(force=True, silent=True) or {}
    try:
        mid = str(data.get("id", "")).strip()
        num_val = data.get("module_num", None)
        module_num = None
        if num_val is not None and num_val != "":
            module_num = int(num_val)
        updated = backend.set_module_number(mid, module_num)
        return jsonify({"ok": True, "module": {"id": updated.id, "module_num": updated.module_num}})
    except Exception as e:
        return jsonify({"ok": False, "error": str(e)}), 400


# ------------------------------------------------------------
# Labels API
# ------------------------------------------------------------
@app.get("/labels/<module_id>")
def labels_get(module_id: str):
    labels = _load_labels()
    return jsonify({"ok": True, "module_id": module_id, "labels": labels.get(module_id, {})})


@app.post("/labels/set")
def labels_set():
    data = request.get_json(force=True, silent=True) or {}
    module_id = str(data.get("module_id", "")).strip()
    if not module_id:
        return jsonify({"ok": False, "error": "module_id required"}), 400

    module_name = str(data.get("module_name", "")).strip()
    channels = data.get("channels", {})

    ch_out: dict[str, str] = {}
    if isinstance(channels, dict):
        for k, v in channels.items():
            ks = str(k).strip()
            vs = str(v).strip()
            if ks.isdigit():
                ch_out[ks] = vs

    labels = _load_labels()
    labels[module_id] = {
        "module_name": module_name,
        "channels": ch_out,
    }
    _save_labels(labels)

    return jsonify({"ok": True})


# ------------------------------------------------------------
# Serve module SVGs
# ------------------------------------------------------------
@app.get("/modules/svg/<module_type>")
def module_svg(module_type: str):
    module_type = (module_type or "").strip().lower()

    svg_map = {
        "di": ("di", "DI.svg"),
        "do": ("do", "DO.svg"),
        "aio": ("aio", "AIO.svg"),
        "head": ("head", "HEAD.svg"),  # optional if you want server-served HEAD.svg later
        "i2c": ("i2c", "I2C_EXPANDER.svg"),
        # Support alternate names for the expander SVG
        "i2c_expander": ("i2c", "I2C_EXPANDER.svg"),
        "rs485": ("rs485", "RS485_MODULE.svg"),
        "generator": ("Generator", "Generator.svg"),
    }

    if module_type not in svg_map:
        abort(404)

    folder, filename = svg_map[module_type]
    svg_dir = BASE_DIR / "modules" / folder

    if not (svg_dir / filename).exists():
        abort(404)

    return send_from_directory(str(svg_dir), filename, mimetype="image/svg+xml")


# ------------------------------------------------------------
# Head module status endpoint
# ------------------------------------------------------------
@app.get("/api/head_status")
def head_status():
    ip = get_lan_ip()
    online = internet_ok_tcp()

    return jsonify(
        {
            "server_running": True,
            "internet_ok": bool(online),
            "ip": ip,
            "ts": int(time.time()),
        }
    )


@app.get("/api/module_errors")
def api_module_errors():
    try:
        backend.health_check_modules()
        return jsonify({"ok": True, "errors": backend.module_errors_by_num()})
    except Exception as e:
        return jsonify({"ok": False, "error": str(e)}), 500


@app.post("/api/module_errors/test_toggle")
def api_module_errors_test_toggle():
    """
    Test helper used by the UI Test button: toggles an error on Module ID 1.
    Always enabled; limited to module_num=1 with a fixed message.
    Body: { "enable": true|false }
    """
    data = request.get_json(force=True, silent=True) or {}
    enable = bool(data.get("enable"))
    try:
        backend.set_last_error_for_module_num(1, "Test-induced error" if enable else None)
        return jsonify({"ok": True})
    except Exception as e:
        return jsonify({"ok": False, "error": str(e)}), 400


@app.post("/api/module_errors/inject")
def api_module_errors_inject():
    """
    Dev/test helper: manually set/clear the last_error for a module so the
    head-module indicators can be verified.

    Enable with FLASK_DEBUG=1 or ALLOW_ERROR_INJECT=1.
    Body:
      { "module_num": 1, "error": "something bad" }
      or { "module_id": "rs485-0x50", "error": "" } to clear.
    """
    if not (app.debug or os.getenv("ALLOW_ERROR_INJECT", "")):
        return jsonify({"ok": False, "error": "inject disabled (set FLASK_DEBUG=1 or ALLOW_ERROR_INJECT=1)"}), 403

    data = request.get_json(force=True, silent=True) or {}
    err = data.get("error")
    err = str(err) if err is not None else None

    try:
        if "module_id" in data and str(data["module_id"]).strip():
            backend.set_last_error_for_module(str(data["module_id"]), err)
        elif "module_num" in data:
            backend.set_last_error_for_module_num(int(data["module_num"]), err)
        else:
            return jsonify({"ok": False, "error": "module_id or module_num required"}), 400
        return jsonify({"ok": True})
    except Exception as e:
        return jsonify({"ok": False, "error": str(e)}), 400


# ------------------------------------------------------------
# GUI helpers API
# ------------------------------------------------------------
@app.get("/api/gui/modules")
def api_gui_modules():
    """Return ordered modules for GUI: head (if any) then slots 1..N.

    Each entry includes slot number, id, type, name, address, present,
    and channel counts for in/out so the UI can build controls.
    """
    mods = backend.list_modules()
    # prefer head first if present
    head = [m for m in mods if m.type == "head"]
    others = [m for m in mods if m.type != "head"]
    ordered = head + others

    if RS485_ONLY:
        # Assume present in RS485-only mode; RS485 comms/health checks will surface actual faults.
        present = {m.address_hex.lower() for m in ordered}
    else:
        addrs, _err = _scan_i2c_addresses(I2C_BUS)
        present = {f"0x{a:02x}" for a in addrs}
        # If running in dev mode, treat addresses found in dev data as present too
        try:
            if backend._dev_mode:
                dev_addrs = {str(k).lower() for k in backend._dev_data.keys()}
                present = present.union(dev_addrs)
        except Exception:
            pass

    out = []
    for i, m in enumerate(ordered, start=1):
        mtype = m.type
        if mtype == "di":
            ch_in = 16
            ch_out = 0
        elif mtype == "do":
            ch_in = 0
            ch_out = 16
        elif mtype == "aio":
            ch_in = 8
            ch_out = 8
        else:
            ch_in = 0
            ch_out = 0

        out.append(
            {
                "slot": i,
                "id": m.id,
                "type": mtype,
                "name": m.name,
                "address": m.address_hex,
                "present": m.address_hex.lower() in present,
                "channels_in": ch_in,
                "channels_out": ch_out,
                "module_num": m.module_num,
                "last_error": backend.get_last_error(m.id),
            }
        )

    return jsonify(out)


@app.post("/api/gui/action")
def api_gui_action():
    """Perform a GUI action: read or write a module channel.

    Payload: { module_id, action: "read"|"write", channel: int, value }
    """
    data = request.get_json(force=True, silent=True) or {}
    module_id = str(data.get("module_id", "")).strip()
    action = str(data.get("action", "read")).strip().lower()

    if not module_id:
        return jsonify({"ok": False, "error": "module_id required"}), 400

    if action == "read":
        try:
            res = backend.read_module(module_id)
            return jsonify(res)
        except Exception as e:
            tb = traceback.format_exc()
            print(tb)
            return jsonify({"ok": False, "error": str(e), "trace": tb}), 400

    elif action == "write":
        try:
            channel = int(data.get("channel", -1))
        except Exception:
            return jsonify({"ok": False, "error": "invalid channel"}), 400

        value = data.get("value")
        # Ensure value is int or float, not None
        if value is None:
            return jsonify({"ok": False, "error": "value is required"}), 400
        # Try to convert to int or float
        try:
            if isinstance(value, (int, float)):
                pass
            elif isinstance(value, str):
                if "." in value:
                    value = float(value)
                else:
                    value = int(value)
            else:
                return jsonify({"ok": False, "error": "value must be int or float"}), 400
        except Exception:
            return jsonify({"ok": False, "error": "value must be int or float"}), 400
        try:
            res = backend.write_module(module_id=module_id, channel=channel, value=value)
            return jsonify(res)
        except Exception as e:
            tb = traceback.format_exc()
            print(tb)
            return jsonify({"ok": False, "error": str(e), "trace": tb}), 400

    else:
        return jsonify({"ok": False, "error": "unknown action"}), 400


# ------------------------------------------------------------
# Simple GUI page
# ------------------------------------------------------------
@app.get("/ui/gui")
def ui_gui():
    return render_template("gui_panel.html")



# ------------------------------------------------------------
# Hat status (power lines), sourced from RS485 module sense masks
# ------------------------------------------------------------
@app.get("/api/hat_status")
def api_hat_status():
    # default address: 0x20 (A0..A2 pulled to GND)
    try:
        addr_env = os.getenv("HC_HAT_ADDR", "0x20")
        if isinstance(addr_env, str) and addr_env.startswith("0x"):
            addr = int(addr_env, 16)
        else:
            addr = int(addr_env, 0)
    except Exception:
        addr = 0x20

    try:
        res = backend.read_hat_status(bus_num=0, address=addr)
        return jsonify(res)
    except Exception as e:
        return jsonify({"ok": False, "error": str(e)}), 500


# ------------------------------------------------------------
# Module read endpoint (module-specific parsing)
# ------------------------------------------------------------
@app.get("/api/module_read/<module_id>")
def api_module_read(module_id: str):
    try:
        res = backend.read_module(module_id)
        return jsonify(res)
    except Exception as e:
        return jsonify({"ok": False, "error": str(e)}), 400


@app.post("/api/module_write")
def api_module_write():
    data = request.get_json(force=True, silent=True) or {}
    module_id = str(data.get("module_id", "")).strip()
    if not module_id:
        return jsonify({"ok": False, "error": "module_id required"}), 400

    # Individual channel write: { module_id, channel: 1-16 (or 1-8 for AIO), value }
    try:
        channel = int(data.get("channel", -1))
    except Exception:
        channel = -1

    # determine module type
    idx = backend._find_module_index(module_id)
    if idx < 0:
        return jsonify({"ok": False, "error": "module not found"}), 400
    mtype = backend.cfg.modules[idx].type

    # parse value based on module type
    if mtype == "do":
        try:
            value = int(data.get("value", -1))
        except Exception:
            value = -1
        if not (1 <= channel <= 16) or value not in (0, 1):
            return jsonify({"ok": False, "error": "invalid channel or value for DO"}), 400

    elif mtype == "aio":
        try:
            # allow numeric or string float
            value = float(data.get("value", "nan"))
        except Exception:
            return jsonify({"ok": False, "error": "invalid voltage value for AIO"}), 400
        if not (1 <= channel <= 8):
            return jsonify({"ok": False, "error": "invalid channel for AIO"}), 400

    else:
        return jsonify({"ok": False, "error": "module type does not support writes"}), 400

    try:
        res = backend.write_module(module_id=module_id, channel=channel, value=value)
        return jsonify(res)
    except Exception as e:
        return jsonify({"ok": False, "error": str(e)}), 400


# ------------------------------------------------------------
# Run
# ------------------------------------------------------------
if __name__ == "__main__":
    host = os.getenv("HC_HOST", "0.0.0.0")
    port = int(os.getenv("HC_PORT", "8080"))
    debug = os.getenv("HC_DEBUG", "0").lower() in ("1", "true", "yes", "on")

    print(f"Home Controller running on http://{host}:{port}")
    print('Registered routes:')
    for rule in app.url_map.iter_rules():
        print(rule)
    app.run(host=host, port=port, debug=debug)
