pengels22/home_controller/home_controller/core/backend_core.py

"""
backend_core.py
Low-level RS485 helpers for talking to the RP2040 module firmwares under
home_controller/core/module_firmware/*_core.ino.

This file frames the request/response packets exactly as the firmware expects:

DI_core.ino (digital input)
  Request 5B : [0xAA][addr][ch][CMD_READ=0x00][crc=xor(first4)]
  Reply   6B : [0x55][addr][ch][value][senseMask][crc=xor(first5)]
  Special ch : 0xFE -> inputs 0..7 in data, 0xFF -> inputs 8..15 in data

DO_core.ino (digital output)
  Request 5B : [0xAA][addr][ch][cmd(0=off,!=0 on)][crc]
  Reply   6B : [0x55][addr][ch][actual_state][senseMask][crc]
  Note: no read-only command; every request is a set operation.

AIO_core.ino (analog in/out)
  Request 7B : [0xAA][addr][ch][cmd][d0][d1][crc]  (crc xor first6)
               cmd 0x00=READ, 0x01=WRITE
               value12 = d0 | ((d1 & 0x0F)<<8)
  Reply   8B : [0x55][addr][ch][cmd][d0][d1][senseMask][crc]

I2C_core.ino (I2C sensor hub)
  Request 9B  : [0xAA][addr][cmd][type][i2c][p0][p1][p2][crc]
  Reply   12B : [0x55][addr][cmd][type][i2c][field][d0][d1][d2][d3][status][crc]
  Only a minimal helper is provided here; higher-level parsing can be added later.

RS485_core.ino (4‑bus expander)
  Upstream request: [0xAA][moduleAddr][bus][len][payload...][crc]
  Upstream reply  : [0x55][moduleAddr][bus][len][payload...][status][crc]

All CRCs are simple XOR of the preceding bytes in the frame.
"""

from __future__ import annotations

import threading
import time
import struct
from typing import Dict, Optional, Any

try:
    import serial  # type: ignore

    _HAS_PYSERIAL = True
except Exception:  # pragma: no cover - optional dependency
    serial = None  # type: ignore
    _HAS_PYSERIAL = False


class RS485NotReady(Exception):
    """Raised when pyserial is missing or the serial port cannot be opened."""


def _xor_crc(buf: bytes) -> int:
    c = 0
    for b in buf:
        c ^= b
    return c & 0xFF


def _pack12(value: int) -> (int, int):
    v = max(0, min(4095, int(value)))
    return v & 0xFF, (v >> 8) & 0x0F


def _unpack12(d0: int, d1: int) -> int:
    return (d0 & 0xFF) | ((d1 & 0x0F) << 8)


def _crc16_ccitt_false(data: bytes) -> int:
    """
    CRC-16/CCITT-FALSE (poly=0x1021, init=0xFFFF, refin/out=false, xorout=0).
    Matches the implementation in gen_core.ino.
    """
    crc = 0xFFFF
    for b in data:
        crc ^= b << 8
        for _ in range(8):
            if crc & 0x8000:
                crc = (crc << 1) ^ 0x1021
            else:
                crc <<= 1
            crc &= 0xFFFF
    return crc


class RS485Backend:
    """
    Thin, synchronous RS485 transport for the RP2040 modules.
    Provides one-call helpers per module type; thread-safe via a single lock.
    """

    def __init__(self, port: str, baudrate: int = 115200, timeout: float = 0.08) -> None:
        if not _HAS_PYSERIAL:
            raise RS485NotReady("pyserial is not installed")
        try:
            self._ser = serial.Serial(
                port=port,
                baudrate=baudrate,
                bytesize=serial.EIGHTBITS,
                parity=serial.PARITY_NONE,
                stopbits=serial.STOPBITS_ONE,
                timeout=timeout,
                inter_byte_timeout=timeout,
            )
        except Exception as exc:
            raise RS485NotReady(f"could not open RS485 port {port}: {exc}")
        self._lock = threading.Lock()
        self._timeout = timeout
        self._gen_seq = 0  # generator frame sequence counter

    @staticmethod
    def available() -> bool:
        return _HAS_PYSERIAL

    # -------------------------------------------------
    # Low-level IO
    # -------------------------------------------------
    def _write_and_read(self, request: bytes, expect_len: int, timeout: Optional[float] = None) -> bytes:
        """Send request bytes and read an exact-length reply or raise TimeoutError."""
        to = timeout if timeout is not None else self._timeout
        end_at = time.time() + to
        with self._lock:
            self._ser.reset_input_buffer()
            self._ser.write(request)
            self._ser.flush()
            buf = b""
            while len(buf) < expect_len:
                remaining = expect_len - len(buf)
                chunk = self._ser.read(remaining)
                if chunk:
                    buf += chunk
                    continue
                if time.time() > end_at:
                    # capture any partial buffer for diagnostics
                    raise TimeoutError(f"RS485 timeout waiting for {expect_len}B reply (got {len(buf)})", request, buf)
        return buf

    # -------------------------------------------------
    # RS485 hub diagnostics (RS485_core.ino control channel)
    # -------------------------------------------------
    def read_rs485_stats(self, addr: int) -> Dict[str, Any]:
        """
        Query the RS485 hub (RP2040 expander) for per-bus error counters and last status.

        Control frame:
          Request : [0xAA][addr][0xFF][len=1][cmd=0x01][crc]
          Reply   : [0x55][addr][0xFF][len][payload...][status][crc]
          Payload : 4x uint16 error counts (bus0..3), 4x uint8 last_status codes
        """
        req = bytes([0xAA, addr & 0xFF, 0xFF, 0x01, 0x01])
        crc = _xor_crc(req)
        req += bytes([crc])

        # expect preamble(1)+addr(1)+bus(1)+len(1)+payload(12)+status(1)+crc(1) = 18
        reply = self._write_and_read(req, expect_len=18)
        if len(reply) != 18 or reply[0] != 0x55 or reply[2] != 0xFF:
            return {"ok": False, "error": "bad preamble/len", "raw": reply}
        if reply[-1] != _xor_crc(reply[:-1]):
            return {"ok": False, "error": "bad crc", "raw": reply}

        plen = reply[3]
        if plen != 12:
            return {"ok": False, "error": f"unexpected payload len {plen}", "raw": reply}

        payload = reply[4:4+plen]
        bus_errors = []
        for i in range(4):
            err = payload[i*2] | (payload[i*2+1] << 8)
            status = payload[8 + i]
            bus_errors.append({"bus": i+1, "errors": err, "last_status": status})

        return {
            "ok": True,
            "addr": reply[1],
            "bus": reply[2],
            "bus_errors": bus_errors,
            "status": reply[-2],
            "raw": reply,
        }

    # -------------------------------------------------
    # DI
    # -------------------------------------------------
    def read_di_bitmap(self, addr: int) -> Dict[str, int]:
        """
        Returns 16-bit DI bitmap and sense mask.
        Uses special channels 0xFE (low byte) and 0xFF (high byte).
        """
        lo = self._read_di(addr, 0xFE)
        hi = self._read_di(addr, 0xFF)
        if not lo["ok"]:
            return lo
        if not hi["ok"]:
            return hi
        bitmap = lo["value"] | (hi["value"] << 8)
        return {
            "ok": True,
            "addr": addr,
            "bitmap": bitmap,
            "sense_mask": lo["sense_mask"] | hi["sense_mask"],
            "raw_lo": lo["raw"].hex(),
            "raw_hi": hi["raw"].hex(),
        }

    def _read_di(self, addr: int, ch: int) -> Dict[str, int]:
        req = bytes([0xAA, addr & 0xFF, ch & 0xFF, 0x00])
        crc = _xor_crc(req)
        req += bytes([crc])
        reply = self._write_and_read(req, expect_len=6)
        if len(reply) != 6 or reply[0] != 0x55:
            return {"ok": False, "error": "bad preamble or length", "raw": reply}
        if reply[-1] != _xor_crc(reply[:-1]):
            return {"ok": False, "error": "bad crc", "raw": reply}
        return {
            "ok": True,
            "addr": reply[1],
            "channel": reply[2],
            "value": reply[3],
            "sense_mask": reply[4],
            "raw": reply,
        }

    # -------------------------------------------------
    # DO
    # -------------------------------------------------
    def write_do(self, addr: int, ch: int, on: bool) -> Dict[str, int]:
        """
        Sets a single DO channel (0-15). No pure read command exists in firmware.
        Returns actual state as reported by the module.
        """
        cmd = 0x01 if on else 0x00
        req = bytes([0xAA, addr & 0xFF, ch & 0xFF, cmd])
        crc = _xor_crc(req)
        req += bytes([crc])
        reply = self._write_and_read(req, expect_len=6)
        if len(reply) != 6 or reply[0] != 0x55:
            return {"ok": False, "error": "bad preamble or length", "raw": reply}
        if reply[-1] != _xor_crc(reply[:-1]):
            return {"ok": False, "error": "bad crc", "raw": reply}
        return {
            "ok": True,
            "addr": reply[1],
            "channel": reply[2],
            "actual": reply[3],
            "sense_mask": reply[4],
            "raw": reply,
        }

    def read_do_bitmap(self, addr: int) -> Dict[str, int]:
        """
        Read 16-bit DO bitmap using special channels 0xFE (low) and 0xFF (high).
        Requires DO_core firmware with read support.
        """
        def _read(ch: int) -> Dict[str, int]:
            req = bytes([0xAA, addr & 0xFF, ch & 0xFF, 0x00])
            crc = _xor_crc(req)
            req += bytes([crc])
            reply = self._write_and_read(req, expect_len=6)
            if len(reply) != 6 or reply[0] != 0x55:
                return {"ok": False, "error": "bad preamble or length", "raw": reply}
            if reply[-1] != _xor_crc(reply[:-1]):
                return {"ok": False, "error": "bad crc", "raw": reply}
            return {"ok": True, "data": reply[3], "sense_mask": reply[4], "raw": reply}

        lo = _read(0xFE)
        if not lo.get("ok"):
            return lo
        hi = _read(0xFF)
        if not hi.get("ok"):
            return hi
        bitmap = lo["data"] | (hi["data"] << 8)
        return {
            "ok": True,
            "addr": addr,
            "bitmap": bitmap,
            "sense_mask": lo.get("sense_mask", 0) | hi.get("sense_mask", 0),
            "raw_lo": lo.get("raw"),
            "raw_hi": hi.get("raw"),
        }

    # -------------------------------------------------
    # AIO
    # -------------------------------------------------
    def read_aio_channel(self, addr: int, ch: int) -> Dict[str, int]:
        """Reads a single AI/AO channel; ch 0-7 = AI, 8-15 = AO setpoint."""
        req = bytes([0xAA, addr & 0xFF, ch & 0xFF, 0x00, 0x00, 0x00])
        crc = _xor_crc(req)
        req += bytes([crc])
        reply = self._write_and_read(req, expect_len=8)
        if len(reply) != 8 or reply[0] != 0x55:
            return {"ok": False, "error": "bad preamble or length", "raw": reply}
        if reply[-1] != _xor_crc(reply[:-1]):
            return {"ok": False, "error": "bad crc", "raw": reply}
        val12 = _unpack12(reply[4], reply[5])
        return {
            "ok": True,
            "addr": reply[1],
            "channel": reply[2],
            "cmd": reply[3],
            "value12": val12,
            "sense_mask": reply[6],
            "raw": reply,
        }

    def write_aio_channel(self, addr: int, ch: int, value12: int) -> Dict[str, int]:
        """Writes AO channel (8-15). value12 is 0-4095 raw DAC units."""
        d0, d1 = _pack12(value12)
        req = bytes([0xAA, addr & 0xFF, ch & 0xFF, 0x01, d0, d1])
        crc = _xor_crc(req)
        req += bytes([crc])
        reply = self._write_and_read(req, expect_len=8)
        if len(reply) != 8 or reply[0] != 0x55:
            return {"ok": False, "error": "bad preamble or length", "raw": reply}
        if reply[-1] != _xor_crc(reply[:-1]):
            return {"ok": False, "error": "bad crc", "raw": reply}
        val12 = _unpack12(reply[4], reply[5])
        return {
            "ok": True,
            "addr": reply[1],
            "channel": reply[2],
            "cmd": reply[3],
            "value12": val12,
            "sense_mask": reply[6],
            "raw": reply,
        }

    # -------------------------------------------------
    # I2C module (minimal)
    # -------------------------------------------------
    def send_i2c_cmd(
        self, addr: int, cmd: int, sensor_type: int, i2c_addr: int, p0: int = 0, p1: int = 0, p2: int = 0
    ) -> Dict[str, int]:
        """
        Sends a single I2C module command and returns one reply frame.
        Multi-reply commands (e.g. scan, sample_all) should be called repeatedly until timeout.
        """
        req = bytes(
            [
                0xAA,
                addr & 0xFF,
                cmd & 0xFF,
                sensor_type & 0xFF,
                i2c_addr & 0xFF,
                p0 & 0xFF,
                p1 & 0xFF,
                p2 & 0xFF,
            ]
        )
        crc = _xor_crc(req)
        req += bytes([crc])
        reply = self._write_and_read(req, expect_len=12)
        if len(reply) != 12 or reply[0] != 0x55:
            return {"ok": False, "error": "bad preamble or length", "raw": reply}
        if reply[-1] != _xor_crc(reply[:-1]):
            return {"ok": False, "error": "bad crc", "raw": reply}
        return {
            "ok": True,
            "addr": reply[1],
            "cmd": reply[2],
            "sensor_type": reply[3],
            "i2c_addr": reply[4],
            "field": reply[5],
            "d0": reply[6],
            "d1": reply[7],
            "d2": reply[8],
            "d3": reply[9],
            "status": reply[10],
            "raw": reply,
        }

    def send_i2c_cmd_multi(
        self,
        addr: int,
        cmd: int,
        sensor_type: int,
        i2c_addr: int,
        p0: int = 0,
        p1: int = 0,
        p2: int = 0,
        timeout: float = 0.6,
        idle_gap: float = 0.08,
    ) -> Dict[str, Any]:
        """
        Sends a command that may return multiple 12B frames. Collects frames until no data is
        received for idle_gap or overall timeout expires.
        """
        req = bytes(
            [
                0xAA,
                addr & 0xFF,
                cmd & 0xFF,
                sensor_type & 0xFF,
                i2c_addr & 0xFF,
                p0 & 0xFF,
                p1 & 0xFF,
                p2 & 0xFF,
            ]
        )
        crc = _xor_crc(req)
        req += bytes([crc])
        frames = []
        with self._lock:
            self._ser.reset_input_buffer()
            self._ser.write(req)
            self._ser.flush()
            deadline = time.time() + timeout
            last_rx = time.time()
            while time.time() < deadline and (time.time() - last_rx) <= idle_gap:
                buf = b""
                while len(buf) < 12 and time.time() < deadline:
                    chunk = self._ser.read(12 - len(buf))
                    if chunk:
                        buf += chunk
                        last_rx = time.time()
                    else:
                        break
                if len(buf) < 12:
                    break
                if buf[0] != 0x55:
                    frames.append({"ok": False, "error": "bad preamble", "raw": buf})
                    continue
                if buf[-1] != _xor_crc(buf[:-1]):
                    frames.append({"ok": False, "error": "bad crc", "raw": buf})
                    continue
                frames.append(
                    {
                        "ok": True,
                        "addr": buf[1],
                        "cmd": buf[2],
                        "sensor_type": buf[3],
                        "i2c_addr": buf[4],
                        "field": buf[5],
                        "d0": buf[6],
                        "d1": buf[7],
                        "d2": buf[8],
                        "d3": buf[9],
                        "status": buf[10],
                        "raw": buf,
                    }
                )
        return {"ok": True, "frames": frames}

    # -------------------------------------------------
    # Generator (FD485 framing from gen_core.ino)
    # -------------------------------------------------
    _GEN_SYNC = b"\xAA\x55"
    _GEN_VER = 0x01
    _GEN_MSG_TELEM = 0x01
    _GEN_MSG_CMD = 0x02
    _GEN_MSG_ACK = 0x03
    _GEN_CABINET_ID = 0x01  # host/head ID

    def _gen_build_frame(self, msg_type: int, dst: int, payload: bytes) -> bytes:
        seq = self._gen_seq & 0xFF
        self._gen_seq = (self._gen_seq + 1) & 0xFF
        hdr = bytes([
            self._GEN_SYNC[0], self._GEN_SYNC[1],
            self._GEN_VER,
            msg_type & 0xFF,
            self._GEN_CABINET_ID,
            dst & 0xFF,
            seq,
            len(payload) & 0xFF,
        ])
        crc = _crc16_ccitt_false(hdr + payload)
        return hdr + payload + bytes([(crc >> 8) & 0xFF, crc & 0xFF])

    def _gen_read_frame(self, timeout: float = 0.5, expect_type: Optional[int] = None, expect_src: Optional[int] = None) -> Dict[str, Any]:
        """Parse one FD485 frame; returns error dict on timeout or CRC failure."""
        deadline = time.time() + timeout

        seen = bytearray()

        def read_exact(n: int, until: float) -> Optional[bytes]:
            out = bytearray()
            while len(out) < n and time.time() < until:
                chunk = self._ser.read(n - len(out))
                if chunk:
                    seen.extend(chunk)
                    out += chunk
            return bytes(out) if len(out) == n else None

        while time.time() < deadline:
            b1 = self._ser.read(1)
            if not b1 or b1 != self._GEN_SYNC[:1]:
                continue
            seen.extend(b1)
            b2 = self._ser.read(1)
            if b2 != self._GEN_SYNC[1:2]:
                continue
            seen.extend(b2)
            hdr_rest = read_exact(6, deadline)
            if hdr_rest is None:
                break
            ver, msg_type, src, dst, seq, plen = hdr_rest
            payload_crc = read_exact(plen + 2, deadline)
            if payload_crc is None:
                break
            payload = payload_crc[:-2]
            crc_got = (payload_crc[-2] << 8) | payload_crc[-1]
            frame = b"".join([self._GEN_SYNC, hdr_rest, payload_crc])
            crc_calc = _crc16_ccitt_false(frame[:-2])
            if crc_calc != crc_got:
                continue
            if ver != self._GEN_VER:
                continue
            if expect_type is not None and msg_type != expect_type:
                continue
            if expect_src is not None and src != expect_src:
                continue
            return {
                "ok": True,
                "type": msg_type,
                "src": src,
                "dst": dst,
                "seq": seq,
                "payload": payload,
                "raw": frame,
            }
        return {"ok": False, "error": "timeout waiting for generator frame", "raw": bytes(seen)}

    def gen_send_cmd(self, addr: int, cmd: int, cmd_flags: int = 0, param1: int = 0, param2: int = 0, token: int = 0, timeout: float = 0.6, trace_logger=None) -> Dict[str, Any]:
        """
        Send a generator command (MSG_CMD) and wait for ACK/NAK.
        """
        payload = bytes([
            cmd & 0xFF,
            cmd_flags & 0xFF,
            param1 & 0xFF, (param1 >> 8) & 0xFF,
            param2 & 0xFF, (param2 >> 8) & 0xFF,
            token & 0xFF, (token >> 8) & 0xFF, (token >> 16) & 0xFF, (token >> 24) & 0xFF,
        ])
        frame = self._gen_build_frame(self._GEN_MSG_CMD, addr, payload)
        with self._lock:
            self._ser.reset_input_buffer()
            self._ser.write(frame)
            self._ser.flush()
            ack = self._gen_read_frame(timeout=timeout, expect_type=self._GEN_MSG_ACK, expect_src=addr)
        if not ack.get("ok"):
            if trace_logger:
                trace_logger("gen_ack_fail", frame, ack.get("raw", b""))
            return ack
        pl = ack.get("payload", b"")
        if len(pl) < 2:
            return {"ok": False, "error": "ack payload too short", "raw": ack.get("raw")}
        detail = pl[2] | (pl[3] << 8) if len(pl) >= 4 else 0
        return {"ok": True, "cmd": pl[0], "result": pl[1], "detail": detail, "raw": ack.get("raw")}

    def gen_snapshot(self, addr: int, timeout: float = 1.2, trace_logger=None) -> Dict[str, Any]:
        """
        Issue CMD_SNAPSHOT and return one telemetry frame as a dict.
        """
        CMD_SNAPSHOT = 0x0A
        ack = self.gen_send_cmd(addr, CMD_SNAPSHOT, timeout=timeout, trace_logger=trace_logger)
        if not ack.get("ok"):
            if trace_logger:
                trace_logger("gen_cmd_fail", b"", ack.get("raw", b""))
            return ack
        with self._lock:
            telem = self._gen_read_frame(timeout=timeout, expect_type=self._GEN_MSG_TELEM, expect_src=addr)
        if not telem.get("ok"):
            if trace_logger:
                trace_logger("gen_telem_fail", b"", telem.get("raw", b""))
            return telem
        payload = telem.get("payload", b"")
        fmt = "<I H h H H H H H H B B H H I H H B B H H H H"
        if len(payload) < struct.calcsize(fmt):
            return {"ok": False, "error": "telemetry payload too short", "raw": telem.get("raw")}
        try:
            (
                uptime_s,
                batt_mv,
                eng_temp_c_x10,
                gen_v_l1_x10,
                gen_v_l2_x10,
                util_v_l1_x10,
                util_v_l2_x10,
                amps_l1_x100,
                amps_l2_x100,
                amps_flags,
                amps_src,
                hz_x100,
                rpm,
                run_seconds,
                alarm_code,
                warn_code,
                state,
                mode,
                flags,
                poll_ms,
                good_frames,
                bad_frames,
            ) = struct.unpack(fmt, payload[:struct.calcsize(fmt)])
        except Exception as exc:
            return {"ok": False, "error": f"telemetry unpack failed: {exc}"}

        return {
            "ok": True,
            "telem": {
                "uptime_s": uptime_s,
                "batt_mv": batt_mv,
                "eng_temp_c_x10": eng_temp_c_x10,
                "gen_v_l1_x10": gen_v_l1_x10,
                "gen_v_l2_x10": gen_v_l2_x10,
                "util_v_l1_x10": util_v_l1_x10,
                "util_v_l2_x10": util_v_l2_x10,
                "amps_l1_x100": amps_l1_x100,
                "amps_l2_x100": amps_l2_x100,
                "amps_flags": amps_flags,
                "amps_src": amps_src,
                "hz_x100": hz_x100,
                "rpm": rpm,
                "run_seconds": run_seconds,
                "alarm_code": alarm_code,
                "warn_code": warn_code,
                "state": state,
                "mode": mode,
                "flags": flags,
                "poll_ms": poll_ms,
                "good_frames": good_frames,
                "bad_frames": bad_frames,
            },
            "raw": telem.get("raw"),
        }

    # -------------------------------------------------
    # Expander raw (optional)
    # -------------------------------------------------
    def send_expander(self, addr: int, bus: int, payload: bytes, timeout: Optional[float] = None) -> Dict[str, object]:
        """
        Talks to RS485_core.ino expander.
        Request: [AA][addr][bus][len][payload...][crc]
        Reply  : [55][addr][bus][len][payload...][status][crc]
        """
        if len(payload) > 255:
            return {"ok": False, "error": "payload too long"}
        req_hdr = bytes([0xAA, addr & 0xFF, bus & 0xFF, len(payload) & 0xFF])
        crc = _xor_crc(req_hdr + payload)
        req = req_hdr + payload + bytes([crc])
        reply = self._write_and_read(req, expect_len=4 + len(payload) + 2, timeout=timeout)
        if len(reply) < 6 or reply[0] != 0x55:
            return {"ok": False, "error": "bad preamble or length", "raw": reply}
        calc_crc = _xor_crc(reply[:-1])
        if reply[-1] != calc_crc:
            return {"ok": False, "error": "bad crc", "raw": reply}
        plen = reply[3]
        payload_out = reply[4 : 4 + plen]
        status = reply[4 + plen]
        return {
            "ok": True if status == 0 else False,
            "addr": reply[1],
            "bus": reply[2],
            "payload": payload_out,
            "status": status,
            "raw": reply,
        }

    # -------------------------------------------------
    def close(self) -> None:
        try:
            self._ser.close()
        except Exception:
            pass
