pengels22/home_controller/(commit log)

2026-02-15 Add 30-pin contract, module pinmaps, registry+validator, and Flask UI pages
2026-02-17 Refactor I2C handling, add head module status API, and update UI components
2026-02-17 Add I2C module read/write endpoints and enhance backend with smbus2 support
2026-02-17 Refactor developer mode handling, enhance error reporting, and improve GUI layout
    [backend.py, server.py]
2026-02-17 Enhance dev mode data handling, improve server response fallback, and add Arduino I2C slave sketch for testing
2026-02-17 Enhance digital output handling in dev mode, update simulated data for GPIO and AIO channels, and ensure pin configuration as output
2026-02-17 Add functionality to change module I2C address and update UI accordingly
2026-02-17 Add I2C address change functionality with user prompt in modal
2026-02-18 Add extension board detection and update LED indicators in HEAD module
2026-02-18 Add I2C_EXPANDER SVG file for module visualization
2026-02-18 Add SVG swap logic for I2C EXPANDER module and back button functionality
2026-02-18 Add EXT click handler and back button functionality for I2C EXPANDER module
2026-02-18 Fetch module data before attaching global click handler for external module
2026-02-18 Add I2C expander SVG mapping to module_svg function
2026-02-18 Adjust back button position for improved spacing in I2C_EXPANDER SVG
2026-02-18 Update SVG fetch path for I2C expander to improve resource loading
2026-02-18 Remove redundant module grid elements from I2C_EXPANDER SVG for cleaner design
2026-02-18 Fix card color and adjust module grid position for improved layout in I2C_EXPANDER SVG
2026-02-18 Update HTML structure for I2C expander SVG in headCard
2026-02-18 Update card color and ensure opacity is set for consistent styling in I2C_EXPANDER SVG
2026-02-18 Update HTML structure for I2C expander SVG in headCard to enhance layout
2026-02-18 Update HTML structure for I2C expander SVG card to improve parent container handling
2026-02-18 Refactor I2C_EXPANDER.svg for improved structure and readability
2026-02-18 Refactor HTML structure for I2C EXPANDER SVG for improved clarity and organization
2026-02-18 Inject SVG into DOM for I2C EXPANDER module
2026-02-18 Fix shadow opacity in I2C_EXPANDER SVG for improved visibility
2026-02-18 Refactor SVG styles for I2C EXPANDER module for improved organization and clarity
2026-02-18 Add SVG styles to I2C EXPANDER module for improved organization and clarity
2026-02-18 Add settings button to I2C EXPANDER module and attach handler for modal
2026-02-18 Refactor expander SVG structure by simplifying HTML and removing unnecessary settings button logic
2026-02-18 Refactor external module click handler and update SVG insertion logic for improved clarity and maintainability
2026-02-18 Enhance expander module by preserving class structure, adding settings button, and improving SVG opacity handling
2026-02-18 Refactor I2C_EXPANDER.svg for improved structure and styling, including LED positioning and class naming consistency
2026-02-18 Implement updateModuleLeds function to manage LED states and visibility
2026-02-18 Update loadModules function to use i2c expander SVG for external modules
2026-02-18 Refactor CSS to remove forced opacity and filter on module cards and SVGs; update click handler to disable EXT indicator interaction
2026-02-18 Refactor CSS to enforce full opacity and remove filters on module cards and SVGs
2026-02-19 Refactor _clearAnyDimState and ensureSvgVisible functions to manage pointer events and display without modifying opacity or filters
2026-02-19 Refactor CSS to remove forced opacity and filter settings for module cards and SVGs, ensuring full visibility
2026-02-19 Add comment to clarify SVG filter/opacity handling for Safari quirks
2026-02-19 Support 'i2c_expander' and 'ext' SVG fetch paths for expander module
2026-02-19 Update CSS variables for improved color contrast and remove opacity filters for better visibility
2026-02-19 Update CSS for module cards and adjust SVG row insertion logic to prevent stacking issues
2026-02-19 Enhance module row styling and improve ext row insertion logic for better layout control
2026-02-19 Ensure full opacity and remove filters for module card backgrounds
2026-02-19 Set module opacity to full and remove filters for improved visibility and styling
2026-02-19 Debug: forcibly clear all opacity/filter from modules area after render
2026-02-19 Fix: ensure full opacity and remove filters from modules and ext rows for better visibility
2026-02-19 Fix: aggressively remove opacity and filters from modules and ext rows for improved visibility
2026-02-19 Fix: enforce full opacity and disable filters for modules to prevent Safari rendering issues
2026-02-19 Fix: add debug logging for computed opacity and filters on module cards to diagnose rendering issues
2026-02-19 Fix: enforce full opacity and remove filters for module elements to improve visibility
2026-02-19 Fix: remove redundant opacity and filter overrides for module elements to streamline rendering
2026-02-19 Fix: remove IP address display from I2C_EXPANDER.svg and adjust module indicators positioning
2026-02-19 Fix: update I2C_EXPANDER.svg to remove EXT indicator and add additional EXT button
2026-02-19 Fix: adjust positioning of output LEDs in AIO, DI, and DO modules for improved layout consistency
2026-02-19 Fix: adjust positioning of channel numbers and LEDs in AIO, DI, and DO modules for improved layout consistency
2026-02-19 Implement AIO max voltage configuration API and frontend integration
2026-02-19 Refactor server.py: reorganize imports and move AIO max voltage config API to the bottom
2026-02-19 Fix: move future annotations import to the top of the file for consistency
    [server.py]
2026-02-19 Refactor server.py: move AIO max voltage API to the top and reorganize imports
2026-02-19 Refactor server.py: remove unused imports and relocate AIO max voltage config API
2026-02-19 Fix: validate and convert value input in api_gui_action for correct data types
    [server.py]
2026-02-19 Fix: correct indentation and duplicate import in backend.py
    [backend.py]
2026-02-19 Add startup module check for I2C bus detection
2026-02-19 Update gear button behavior in loadModules: redirect to expansion_config for external modules
2026-02-19 Add error handling for UI rendering in root route
    [server.py]
2026-02-19 Add debug print statement to expansion_config route for request method tracking
2026-02-19 Add debug print statements to list registered routes on startup
2026-02-19 Update gear onclick handler to show expansion settings popup
2026-02-19 Update gear onclick handler to show IO Channel Popup for all module types
2026-02-19 Refactor module name and I2C address input layout for improved styling and consistency
2026-02-19 Refactor AIO module channel input layout to improve naming and add max voltage fields
2026-02-19 Enhance IO Channel Popup to display channel-specific information and controls for AIO, including max voltage and drive functionality
2026-02-19 Add current voltage display to IO Channel Popup and remove global max voltage input from AIO settings
2026-02-19 Fetch and display current invert/override state in IO Channel Popup before saving
2026-02-19 UX: Remove Save button from global DI/DO settings popup; auto-validate and save on close (button or overlay).
2026-02-19 UX: Remove Save button from per-channel DI/DO/AIO popup; auto-save on close (button or overlay).
2026-02-20 UI: Remove extra close button from global DI/DO popup; only bottom center Close button saves and closes.
2026-02-20 UI: Remove top right close button from global popup; only bottom center saves/closes. Fix per-channel popup to prevent module duplication on close.
2026-02-20 UI: Restore close button for per-channel popups; ensure global popup close button is styled and positioned bottom center.
2026-02-20 UI: Only show close button for global popup; ensure global close button saves settings. Remove floating close button from per-channel popups and restore auto-save on overlay click.
2026-02-20 UI: Update global popup save behavior to only allow saving via bottom center Close button; remove overlay click save functionality.
2026-02-20 UI: Only show and position close button for global popup (bottom center); never for per-channel popups. Use CSS for placement.
2026-02-20 UI: Add per-channel close button (top-right, small). Global close button is bottom center, not floating. CSS fixes for placement.
2026-02-20 UI: Always show per-channel close button for channel popups; always remove for global popups. Fix button rendering logic.
2026-02-20 UI: Insert per-channel close button as first child for top-right visibility.
2026-02-20 UI: Increase z-index and top padding for per-channel close button visibility.
2026-02-20 UI: Always insert per-channel close button after controls for channel popups. Fix timing and DOM order issues.
2026-02-20 UI: Fix per-channel close button logic and ensure popup/overlay are fully reset to prevent duplication.
2026-02-20 UI: Move per-channel close button to bottom center, label it 'Close', update CSS for placement and style.
2026-02-20 UI: Make close buttons save info before closing (per-channel and global).
2026-02-20 UI: Remove extra close button from global popup template, ensure only one close button, always reload modules for sync.
2026-02-20 UI: Ensure per-channel close button is always visible and functional for channel popups, never present for global popups.
2026-02-20 UI: Append per-channel close button immediately after controls, guarantee it closes popup after saving.
2026-02-20 UI: Ensure per-channel close button always closes popup, even if save fails or is slow. Add basic error handling.
2026-02-20 UI: Per-channel close button disables, shows spinner, and waits for save to finish before closing popup. Guarantees save completes before close.
2026-02-20 UI: Per-channel close button now uses same save logic as global module settings, ensuring reliable save/close behavior. Fixes all per-channel popup save issues.
2026-02-20 AIO: Allow per-channel popup to accept empty drive voltage input (no error, no change if blank). Only validate and send if a value is entered.
2026-02-20 AIO: Fix per-channel close button to never error about missing input, just closes. Only DI/DO require override/invert for save. AO 'Set Voltage' and Drive logic unchanged.
2026-02-20 UI: Refactor channel close button logic to unify save behavior with global settings, enhancing reliability and user feedback.
2026-02-20 UI: Simplify channel close button logic by integrating saveChannelOnClose function, improving error handling and user feedback.
2026-02-20 UI: Enhance AO channel popup with max voltage input and save functionality, improving user control and feedback
2026-02-20 UI: Enhance AIO channel popup with max voltage input validation and save functionality, improving user experience and error handling
2026-02-20 UI: Enhance AIO channel popup to display active max voltage and load persisted settings, improving user feedback and configuration management
2026-02-20 UI: Enhance AIO channel popup to display latest max voltage in the UI, improving user feedback and visibility
2026-02-20 UI: Enhance AIO channel popup with improved save functionality and loading of max voltage settings, enhancing user experience and data handling
2026-02-20 UI: Enhance AIO channel popup to include a Save button for setting voltage, improving user interaction and data persistence
2026-02-20 UI: Update SVG module dimensions for AIO, DI, DO, HEAD, and I2C EXPANDER, ensuring consistent layout and improved visual alignment
2026-02-20 UI: Resize I2C Expander SVG dimensions to 100x250 and remove shadow for improved clarity
2026-02-20 UI: Update I2C Expander SVG dimensions and styles for improved clarity and consistency
2026-02-21 UI: Adjust I2C Expander SVG text sizes and positions for improved readability
2026-02-21 UI: Refactor I2C Expander SVG layout and styles for improved clarity and consistency
2026-02-21 UI: Refactor I2C Expander SVG structure and styles for improved clarity and consistency
2026-02-21 UI: Refactor I2C Expander SVG channel group IDs for improved consistency
2026-02-24 Add RS485 module support: SVG, backend route, dropdown option. Skip address validation for RS485. Prepare for DIP switch UI.
2026-02-24 UI: Add DIP switch configuration for RS485 module with address auto-calculation
2026-02-24 Remove i2c detection logic and calls; DIP switch UI for RS485 add module page.
2026-02-24 UI: Update I2C scan API to return empty addresses and set all modules as present
2026-02-25 UI: Refactor RS485 address calculation to always use DIP switches; update labels and input attributes
2026-02-25 Remove address input, left-align DIP switch UI under selections, address display above sliders.
2026-02-25 UI: Add DIP switch styles and hidden input fields for module configuration
2026-02-25 UI: Implement DIP switch toggle logic and address display update for Add Module page
2026-02-25 UI: Disable I2C address validation for all modules in modules_add function
2026-02-25 Add remove button for all module types in global settings popup (except head)
2026-02-25 Fix: always show remove button for AIO and EXT/I2C cards in global settings popup
2026-02-28 Refactor: Update module types to include I2C and adjust related configurations
2026-02-28 Refactor: Update AIO module functions to use module_id instead of I2C address and enhance HTML templates for RS485 address configuration
2026-03-01 Add RS485-to-I2C module settings popup with DIP switch configuration and channel inputs
2026-03-01 Add RS485-to-I2C module settings form with DIP switch configuration and channel inputs
2026-03-01 Refactor: Remove legacy I2C module settings form and related content
2026-03-01 Refactor: Update channel input fields to include type selection for I2C addresses
2026-03-01 Add I2C sensor configuration support with dynamic dropdown options
    [i2c_sensors.csv]
2026-03-01 Add expansion configuration for RS485-to-I2C module with channel details
2026-03-01 Refactor: Update form actions to clarify save button functionality
2026-03-01 Add Save button functionality for DI/DO module settings
2026-03-01 Refactor: Update form actions for DI/DO module settings with improved button styles
2026-03-01 Remove unnecessary closing bracket from showIoChannelPopup function
2026-03-01 Enhance loadModules function to support I2C type and improve popup behavior after saving expansion config
2026-03-01 Add GenMon module support with address mapping and details button
2026-03-06 Add RS485 core module and Generac maintenance port gateway firmware
    - Implement RS485 core module for XIAO RP2040 with dual SC16IS752 SPI-UART bridges.
    - Define communication protocol for upstream and downstream frames including CRC validation.
    - Create Generac maintenance port gateway with FD485 framing and telemetry handling.
    - Implement command handling for start, stop, exercise, and mode setting.
    - Add telemetry data structure and functions for CT RMS sampling and blending.
    - Establish UART communication settings and protocols for both FD485 and Generac interfaces.
2026-03-06 Enhance power loss handling in AO bank and add timeout for bus write operations
2026-03-06 Add sense/power indicator helpers and enhance response structure for HomeControllerBackend
2026-03-06 Enhance status LED handling and add support for power and link indicators in various modules
2026-03-06 Enhance LED control by turning off status LEDs in _allLedOff and pre-lighting indicators in runTestLoop
2026-03-06 Enhance LED handling in _setAllIndicators to support generator module with specific LED behavior
2026-03-06 Enhance LED state management in _setAllIndicators for generator module, adding support for 'led-ok' and 'led-run' states
2026-03-06 Update LED color definitions and enhance _setStatusLed for improved state management
2026-03-06 Enhance power status LED cycling for multi-power modules in _setAllIndicators
2026-03-06 Enhance LED cycling behavior in _setAllIndicators for power and link status
2026-03-06 Add battery level simulation and color mapping in _setAllIndicators for improved visual feedback
2026-03-06 Enhance battery level simulation for smoother transitions and full range cycling in runTestLoop
2026-03-06 Add module number management and error handling in HomeControllerBackend
    [backend.py]
2026-03-06 Add module number management and error handling in HomeControllerBackend and server API
    [backend.py, server.py]
2026-03-06 Add module number selection and error handling in module settings forms
    [server.py]
2026-03-06 Enhance module ID generation to support RS485-based modules and prevent address collisions
    [backend.py]
2026-03-06 Improve error message for duplicate module IDs to include module name and address
    [backend.py]
2026-03-06 Add DIP switch wiring and address change handling in IO Channel Popup
2026-03-06 Add test toggle API for module errors and update client-side error injection
    [server.py]
2026-03-06 Add manual error tracking for modules and update API to return errors by module number
    [backend.py, server.py]
2026-03-07 485 updates as well as i2c
    [i2c_sensors.csv]
2026-03-07 Update I2C module labels and enhance sensor data display in popup
2026-03-07 Add 'Save & Close' button text and implement module removal functionality in IO Channel Popup
2026-03-07 Refactor module settings popups to include 'Remove This Module' and 'Save & Close' buttons for improved user experience
2026-03-07 Refactor module settings popups to remove 'Remove This Module' button and update 'Save & Close' button styling for consistency
2026-03-07 Refactor IO Channel Popup to remove close button and update form actions for improved layout
2026-03-07 Update 'Save & Close' button text to 'Save' for consistency across IO Channel Popup
2026-03-07 Refactor save button classes for consistency across module settings popups
2026-03-07 Update 'Save & Close' button text to 'Save' for consistency in IO Channel Popup
2026-03-07 Increase minimum width of 'Save' button in module settings popups for improved usability
2026-03-07 Add consistent global save button styles across module popups
2026-03-07 Add remove button functionality to IO Channel Popup for module management
2026-03-07 feat: implement RS485-only mode, disabling direct I2C access
2026-03-07 chore: remove aio_slave.ino and arduino_serial_to_dev.py files; update requirements.txt for clarity
2026-03-07 Add Module schematics as PDF's
2026-03-07 feat: update documentation and UI for RS485 integration; remove I2C references
2026-03-07 feat: deprecate expansion module; update UI and API references to RS485 I2C Bridge
2026-03-07 feat: rename and replace expansion module configuration; introduce i2c_module_ch_config.json and update related templates
    [server.py]
2026-03-07 feat: remove DIP switch instructions from module settings popups for cleaner UI
2026-03-08 feat: implement AIO voltage management with alerts and UI updates
2026-03-08 feat: add RS485 diagnostics and error handling for bus status in backend and frontend
    [RS485_core.ino, backend.py, backend_core.py]
2026-03-08 feat: implement RS485 bus error handling and status reporting in backend
    [backend.py]
2026-03-08 feat: implement atomic config saving to prevent corruption after crashes
    [backend.py]
2026-03-08 feat: enhance config loading with backup support and implement atomic saving to prevent data loss
    [backend.py]
2026-03-08 feat: update CSS and JS file versions for consistency across templates and improve LED indicator functionality
